DRuggeri/labinator_site/content/docs/buildlog/images/20250603_185943.jpg

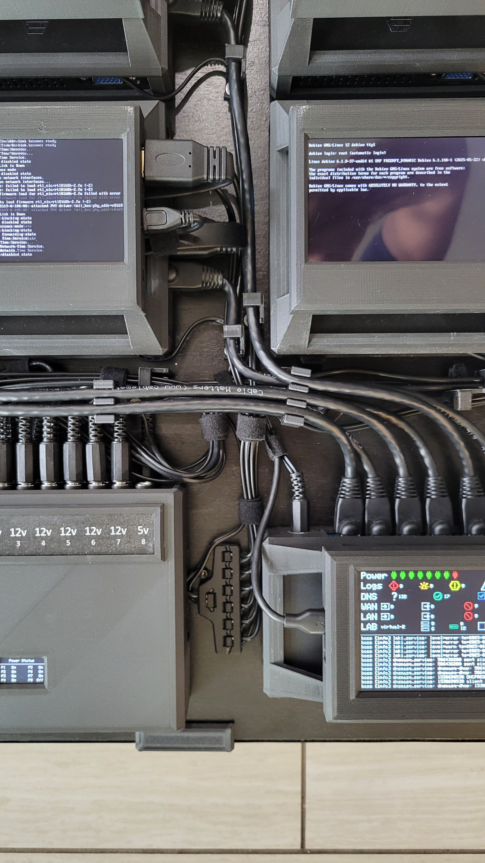
content/docs/buildlog/images/20250603_185943.jpg
