DRuggeri/labinator_site/content/docs/thanks.md

---
Title: Words of Thanks
---

A few content creators and "random Internet folks" have taken the time to share their learnings, code, and links on various blogs or sites. Some have been so handy they are worth a shoutout. I started collecting some of these links far too late in the process so only wish I had the foresight to create an index since the get-go!

#### People
* Thanks to [Werner Rothschopf](https://werner.rothschopf.net/index.htm) for sharing his [analysis of the ESP32 relay board](https://werner.rothschopf.net/microcontroller/202208_esp32_relay_x8_en.htm)
* Thanks to [Dawid Zyla](https://www.dzyla.com/about/about/) for sharing his [quick and easy Hugo shortcode for image galleries](https://www.dzyla.com/blog/post38/)
* Thanks to [Nelson Morais](https://www.linkedin.com/in/njmorais/) for his work [reverse engineering a marionette client for Gecko](https://github.com/njasm/marionette_client)
* Thanks to [Martino](https://martinomagnifico.github.io) for the handy reveal.js plugins he made like [simplemenu](https://github.com/martinomagnifico/reveal.js-simplemenu)
* Thanks to [Felix Stein](https://flxn.de/) for the awesome [QR Code STL file generator](https://printer.tools/qrcode2stl/) (and other cool stuff on [printer.tools](https://printer.tools/))
* Thanks to [Shuntaro Nishizawa](https://s2n.tech/) for the handy [SVG to favicon generator](https://favicon-generator.s2n.tech/)

#### Projects
* [Iconify](https://iconify.design/) - a project by [Vjacheslav Trushkin](https://iconify.design/about/) to collect Open Source icons
* [Hugo](https://gohugo.io/) - the best static content site generator which has rendered these pages you're viewing
* [Hextra](https://imfing.github.io/hextra/) - Hugo theme by [Xin](https://imfing.com/) to make a decent looking site
* [reveal.js](https://revealjs.com/) created by [Hakim El Hattab](https://twitter.com/hakimel) - for an awesome presentation framework to make the lab display
* [PlatformIO](https://platformio.org/) community - making ESP32 embedded development better every day
