DRuggeri/labinator_site/content/docs/subprojects/_index.md

---
title: Subprojects
weight: 3
---
Labinator is a pretty cool project overall, but it is composed of a several sidequests, too!

The pages here are some lighter-weight documentation about those projects, their motivations, and why they came into being.

## Core Components

- **[Labwatch](/docs/subprojects/labwatch/)** - Main lab controller and orchestrator
- **[Relayinator](/docs/subprojects/relayinator/)** - Power management and relay control
- **[Statusinator](/docs/subprojects/statusinator/)** - Status display and monitoring
- **[Boss](/docs/subprojects/boss/)** - Configuration for the boss under the screens
