DRuggeri/labinator_site/content/_index.md

---
toc: false
layout: hextra-home
---

{{< hextra/hero-container
  image="/images/landing.png"
  imageTitle="Labinator"
  imageWidth="999999"
>}}

<div class="hx-mt-6 hx-mb-6">
{{< hextra/hero-headline >}}
  Labinator
{{< /hextra/hero-headline >}}
</div>

<div class="hx-mt-6 hx-mb-6">
{{< hextra/hero-subtitle >}}
  Labinator is the outcome of several weeks of experimentation and playing in my homelab. At the time, my main objective was to experiment with lightweight ways to stand up, run, and operate a Kubernetes cluster. This is awesome both for home use and [dayjob](https://www.linkedin.com/in/danielruggeri). After all - rapid experimentation allows for quick try/fail/retry cycles until a winning combination is found!
{{< /hextra/hero-subtitle >}}
</div>

<div class="hx-mt-6 hx-mb-6">
{{< hextra/hero-button text="Check it out" link="docs/" >}}
</div>
{{< /hextra/hero-container >}}
