DRuggeri/labinator_site/content/docs/improve/images/loadstatus.png

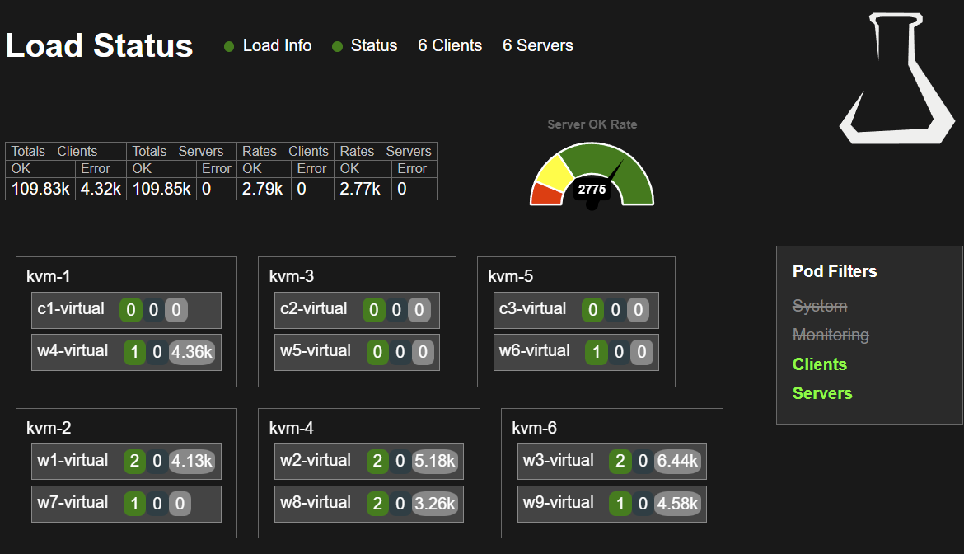
content/docs/improve/images/loadstatus.png
