DRuggeri/labinator_site/content/docs/improve/images/ogstatus.png

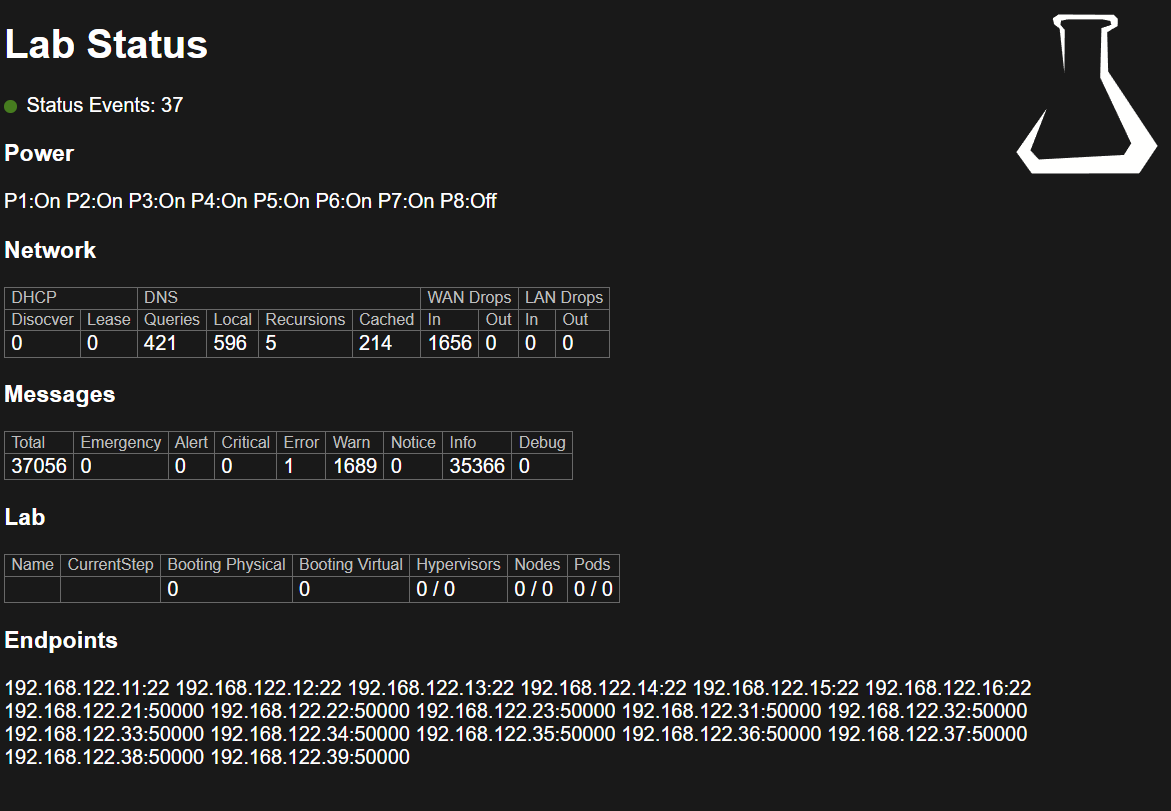
content/docs/improve/images/ogstatus.png
