DRuggeri/labinator_site/content/docs/layout/images/layout-export-boss.png

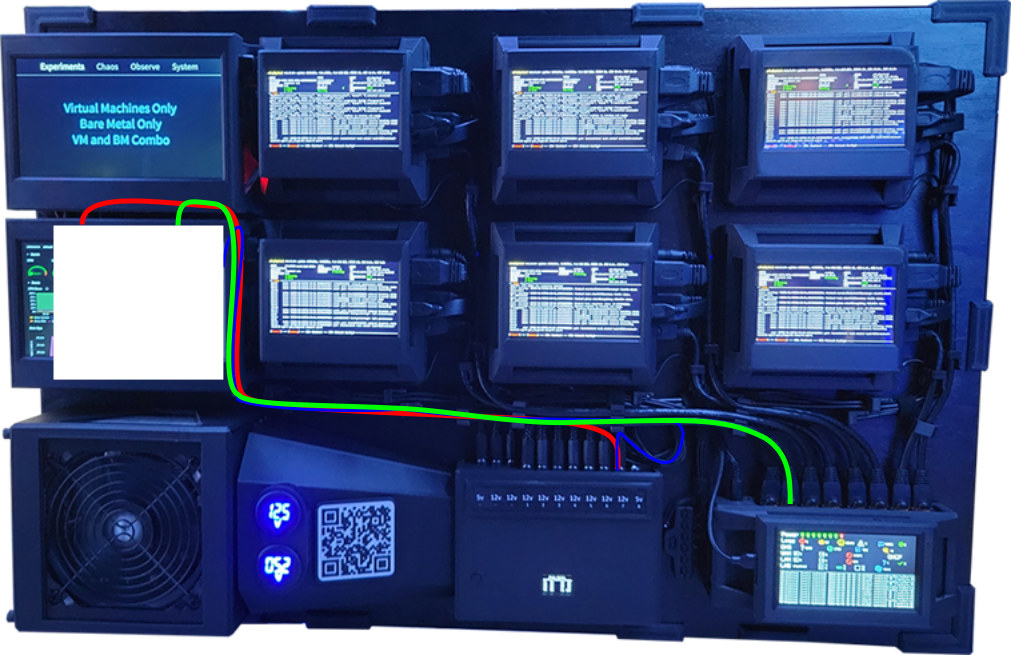
content/docs/layout/images/layout-export-boss.png
