DRuggeri/labinator_site/content/docs/layout/images/layout-export-node1.png

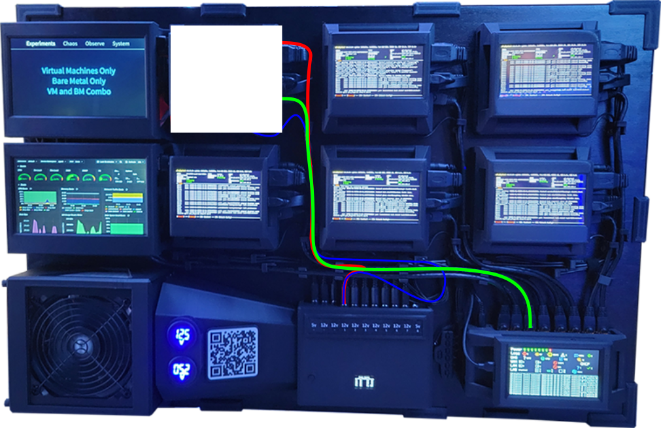
content/docs/layout/images/layout-export-node1.png
