DRuggeri/labinator_site/content/docs/layout/images/layout-export-node2.png

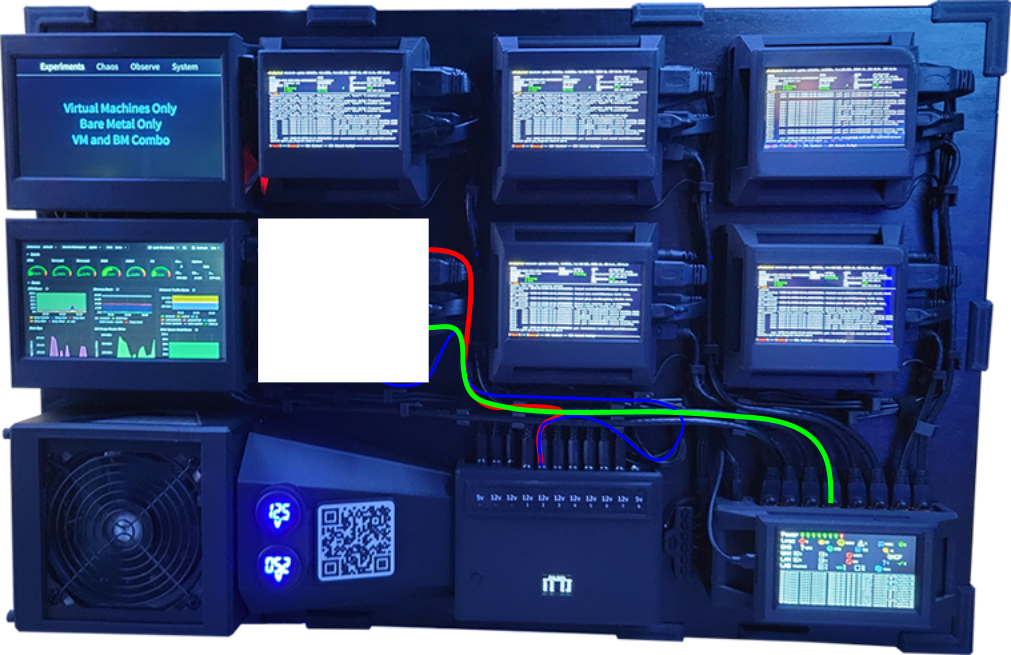
content/docs/layout/images/layout-export-node2.png
