DRuggeri/labinator_site/content/docs/layout/images/layout-export-node3.png

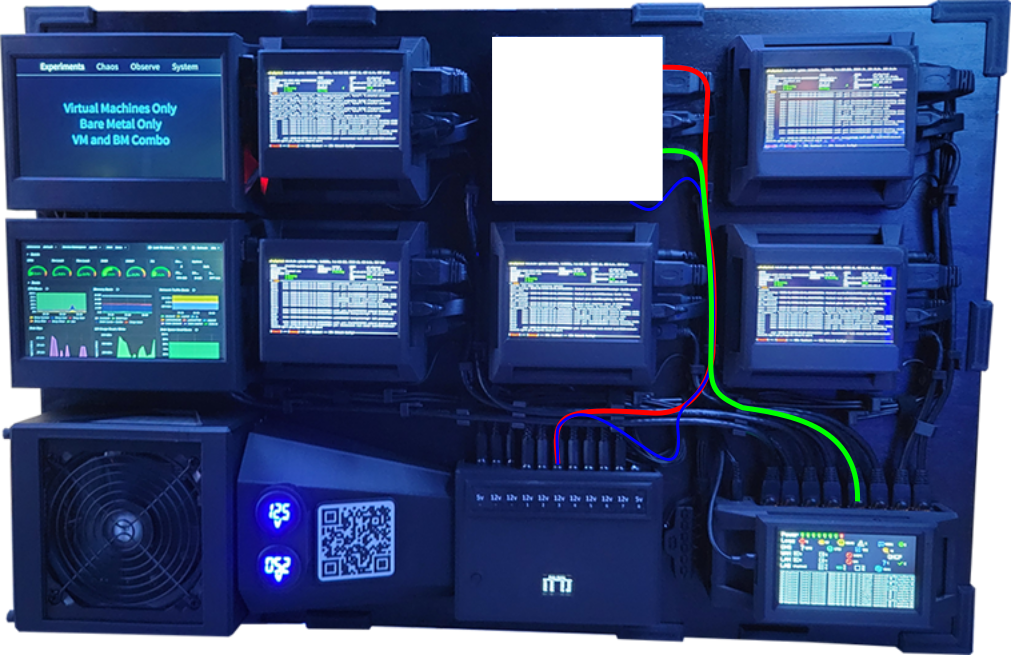
content/docs/layout/images/layout-export-node3.png
