DRuggeri/labinator_site/content/docs/layout/images/layout-export-node4.png

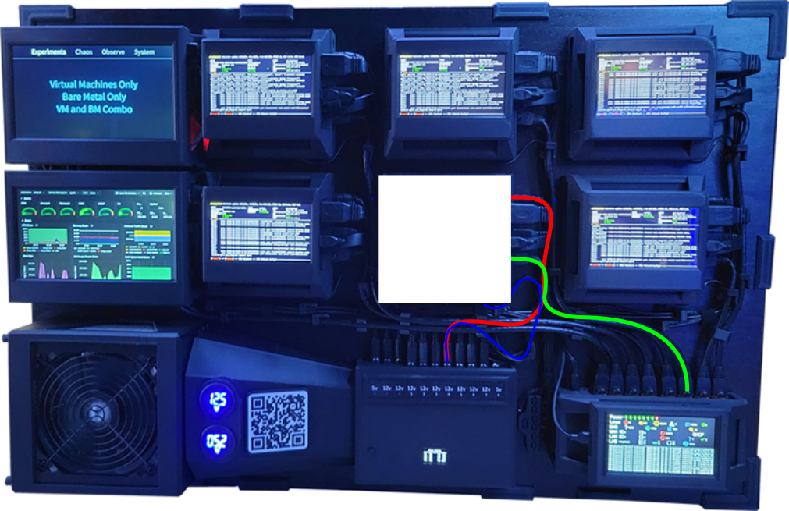
content/docs/layout/images/layout-export-node4.png
