DRuggeri/labinator_site/content/docs/layout/images/layout-export-node5.png

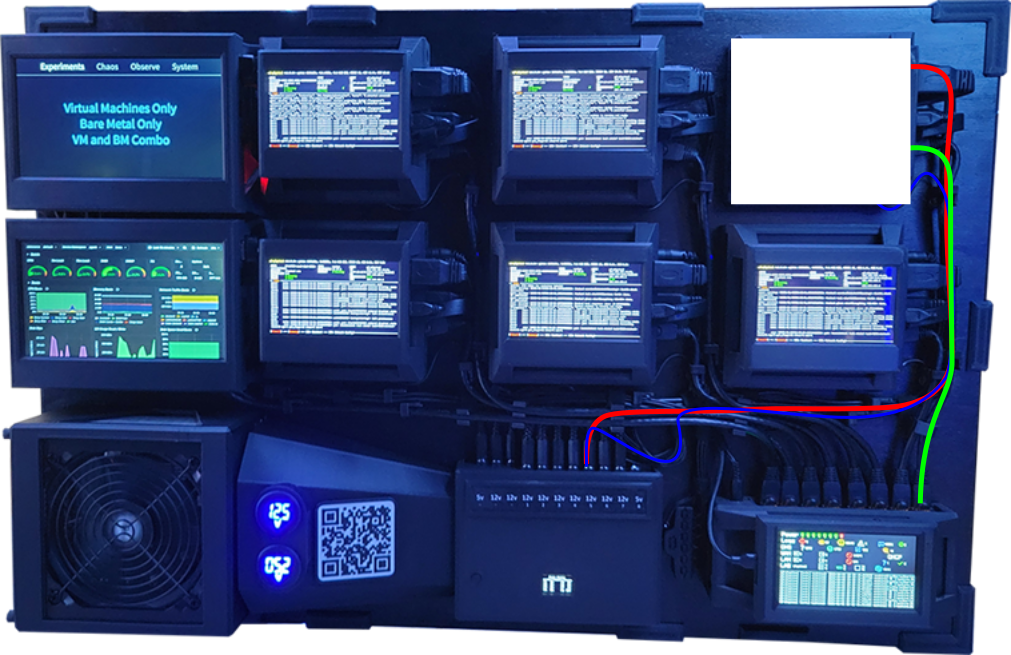
content/docs/layout/images/layout-export-node5.png
