DRuggeri/labinator_site/content/docs/layout/images/layout-export-node6.png

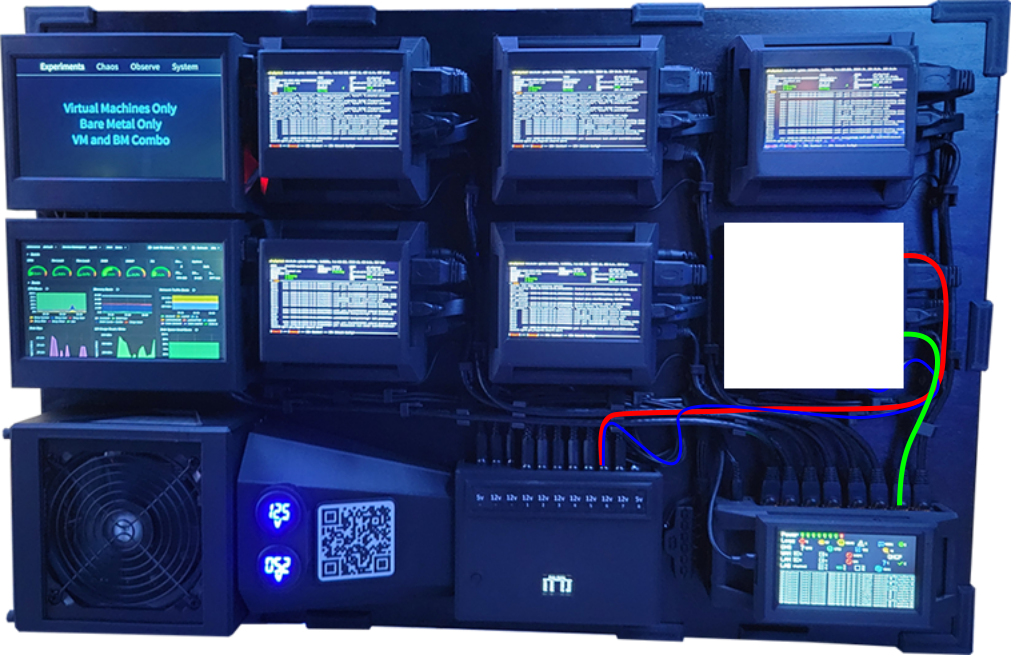
content/docs/layout/images/layout-export-node6.png
