DRuggeri/labinator_site/content/docs/layout/images/layout-export-relayinator.png

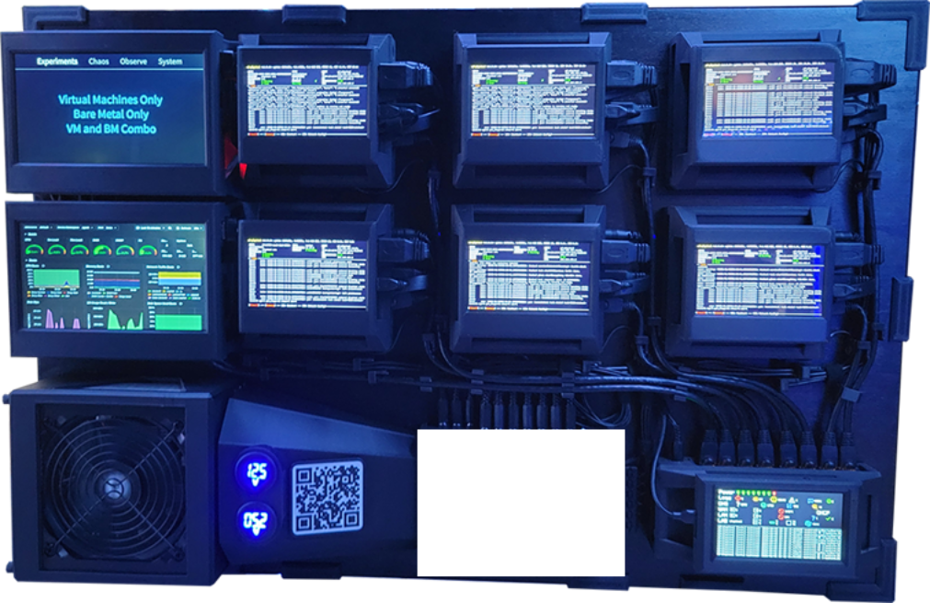
content/docs/layout/images/layout-export-relayinator.png
