DRuggeri/labinator_site/content/docs/layout/images/layout-export-statusinator.png

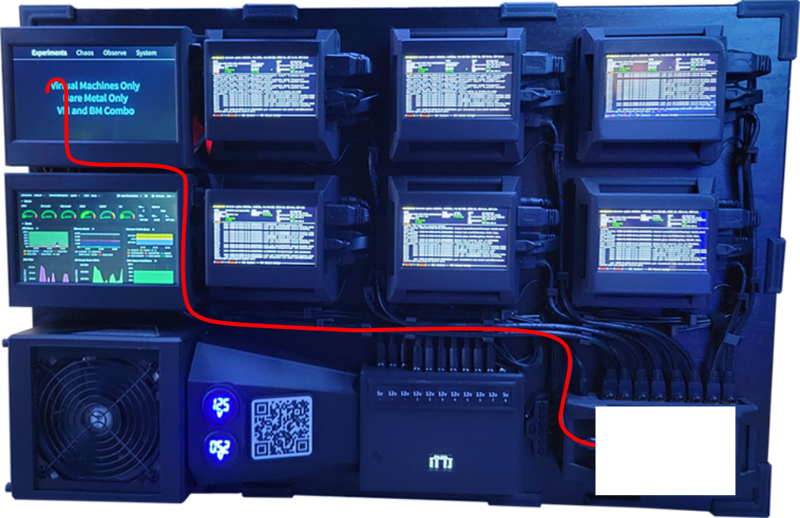
content/docs/layout/images/layout-export-statusinator.png
