DRuggeri/labinator_site/content/docs/layout/images/layout-export.png

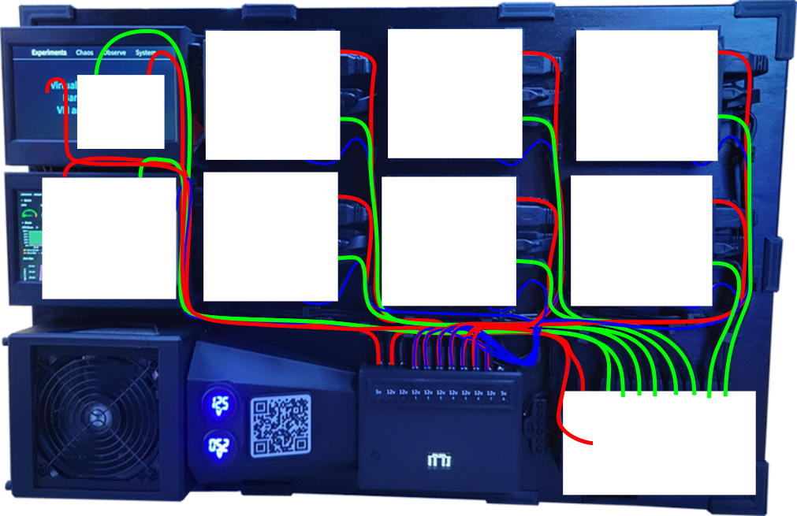
content/docs/layout/images/layout-export.png
