DRuggeri/labinator_site/content/docs/subprojects/relayinator/images/20250119_201037.jpg

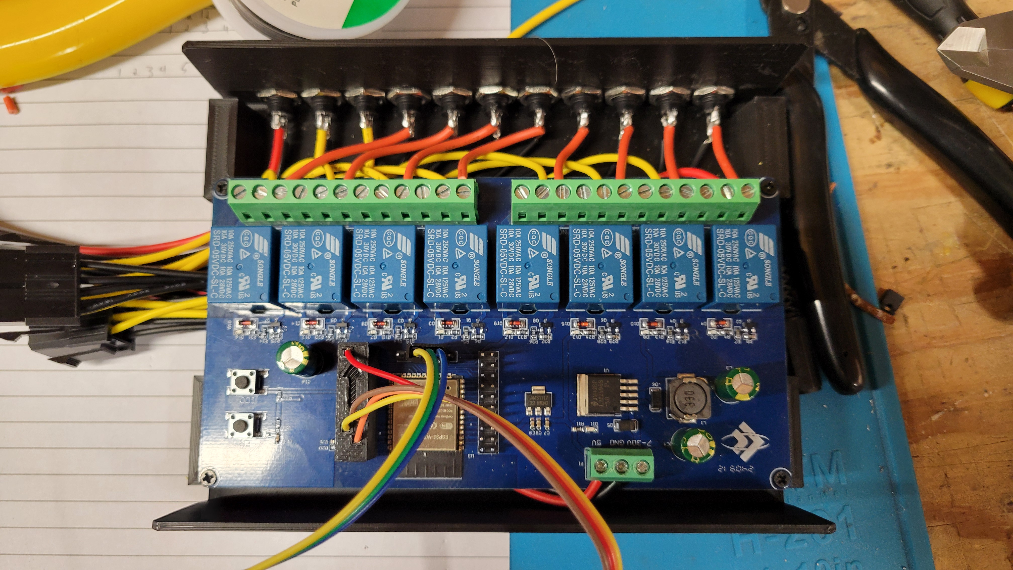
content/docs/subprojects/relayinator/images/20250119_201037.jpg
