DRuggeri/labinator_site/content/docs/subprojects/relayinator/images/20250323_155620.jpg

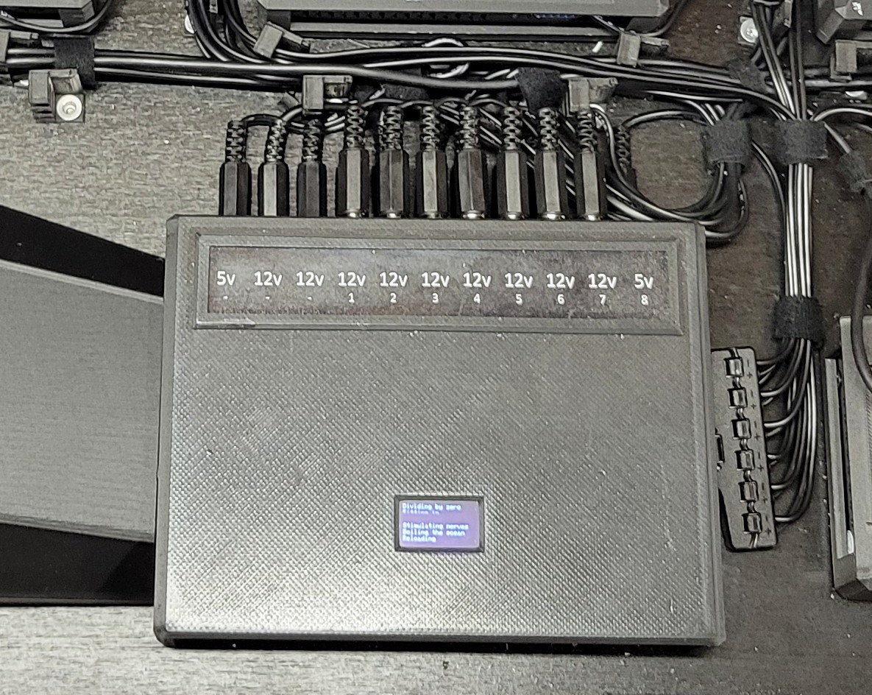
content/docs/subprojects/relayinator/images/20250323_155620.jpg
