DRuggeri/labinator_site/content/docs/subprojects/relayinator/images/20250323_155624.jpg

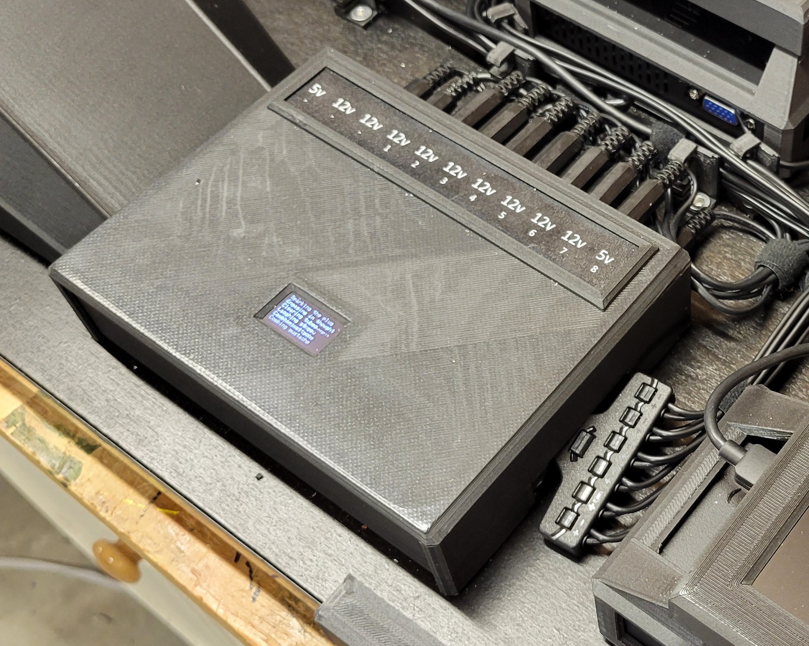
content/docs/subprojects/relayinator/images/20250323_155624.jpg
