DRuggeri/labinator_site/content/docs/subprojects/relayinator/images/20250603_185526.jpg

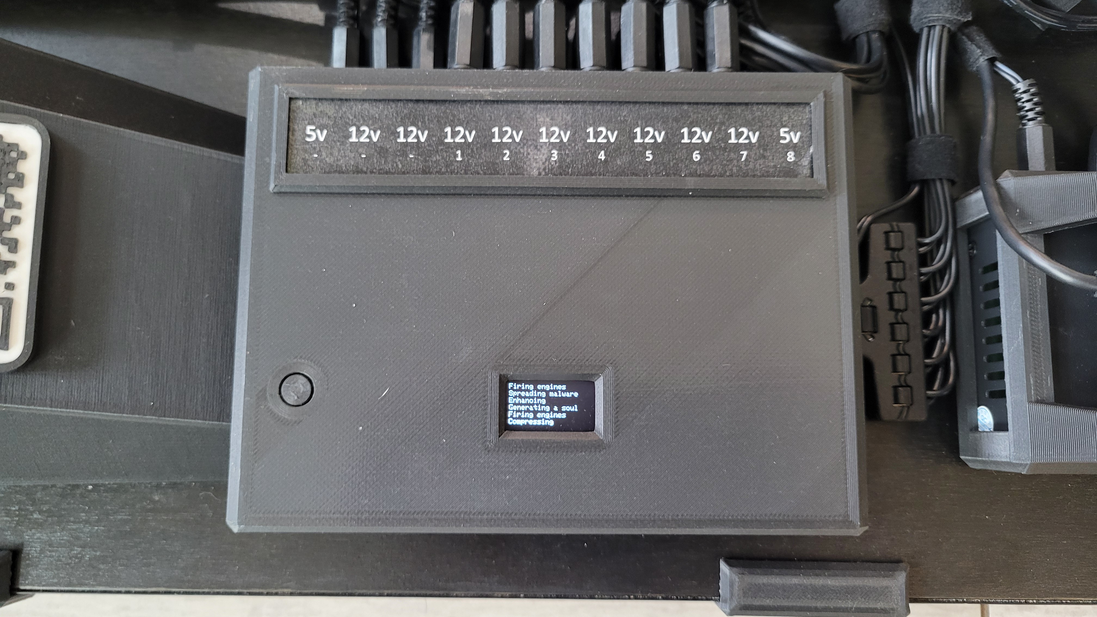
content/docs/subprojects/relayinator/images/20250603_185526.jpg
