DRuggeri/labinator_site/content/docs/subprojects/statusinator/images/20250603_185522.jpg

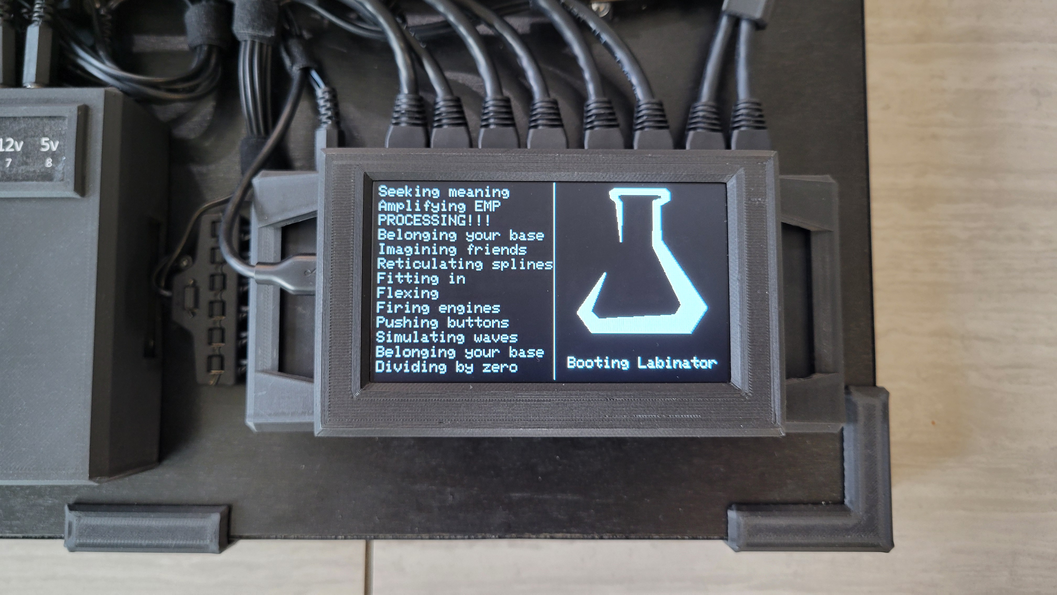
content/docs/subprojects/statusinator/images/20250603_185522.jpg
