DRuggeri/labinator_site/content/docs/subprojects/statusinator/images/20250603_190112.jpg

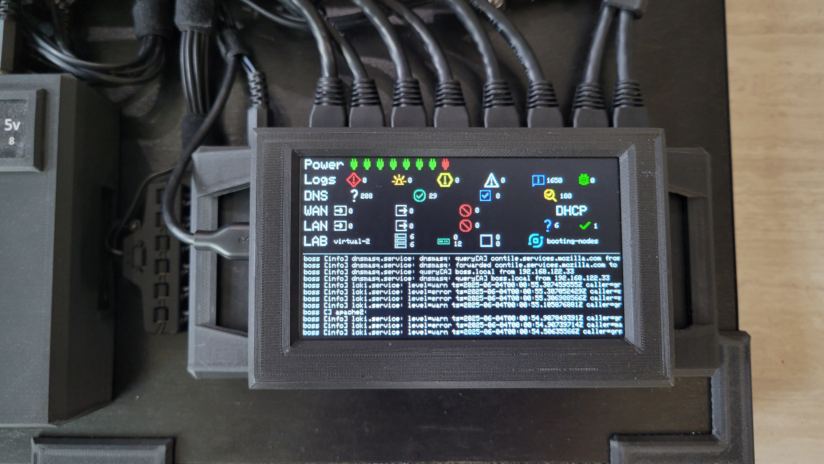
content/docs/subprojects/statusinator/images/20250603_190112.jpg
