DRuggeri/labinator_site/static/android-chrome-192x192.png

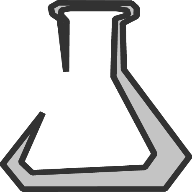
static/android-chrome-192x192.png
