DRuggeri/labinator_site/static/images/landing.jpg

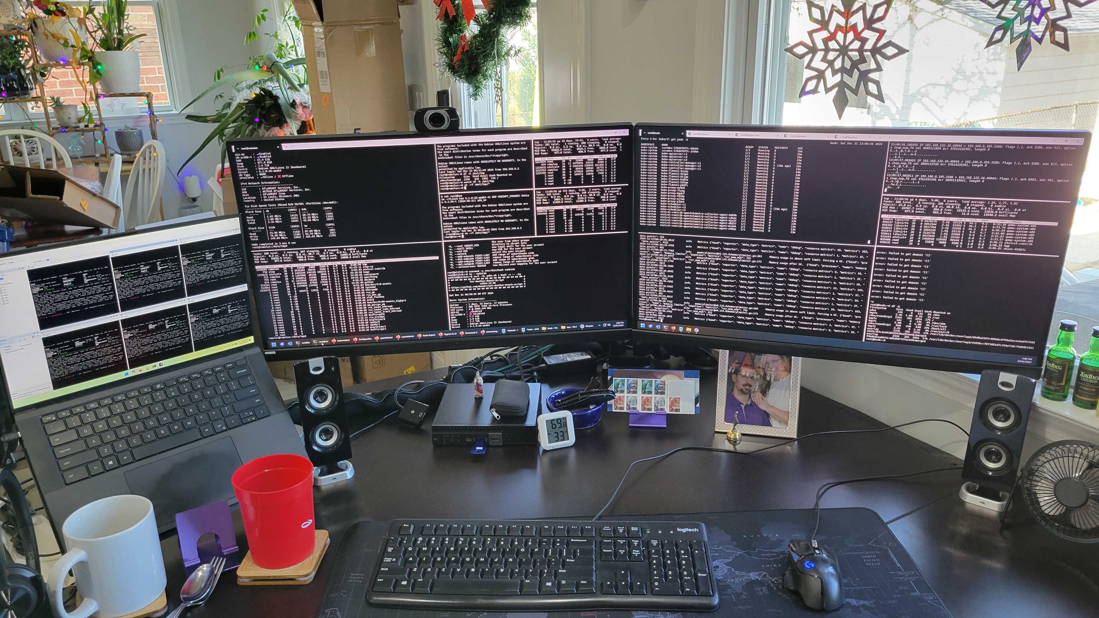
static/images/landing.jpg
