DRuggeri/labinator_site/static/images/models.png

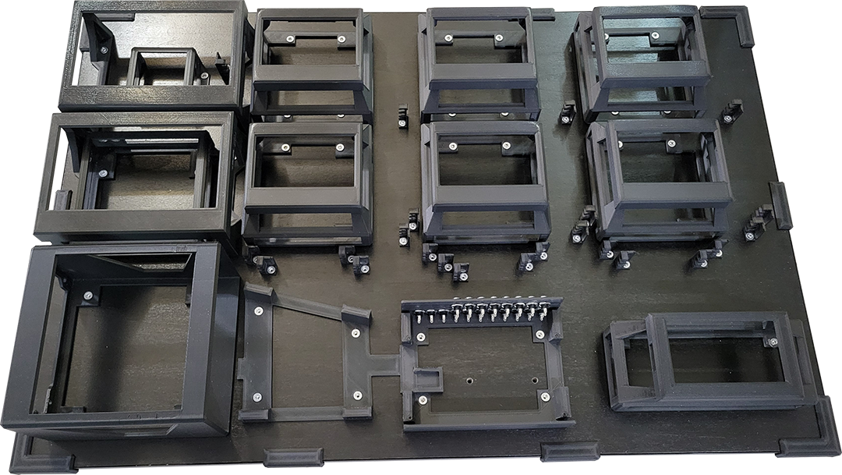
static/images/models.png
