DRuggeri/labinator_site/content/docs/bom.md

---
Title: Bill of Materials
layout: bom
Weight: 6
params:
  parts:
  - item: FriendlyElec NanoPi R3S
    description: Ingress router and firewall running OpenWRT
    link: https://www.aliexpress.us/item/3256807441571917.html
    price: 47.67
    quantity: 1
    purpose: core
  - item: Hasivo S800W-8G-SE 8 port managed switch
    description: Network switch with VLAN support
    link: https://www.aliexpress.us/item/3256804662423078.html
    price: 38.00
    quantity: 1
    purpose: core
  - item: MLLSE M2 Pro Mini PC
    description: Celeron J3710 CPU, 8G RAM, 256G SATA SSD. 6 nodes and 1 boss
    link: https://www.aliexpress.us/item/3256807948148460.html
    price: 79.00
    quantity: 7
    purpose: core
  - item: Apevia ATX-SP700 Spirit ATX power supply
    description: 115/230v power supply with 120mm fan
    link: https://www.amazon.com/dp/B08BZYG24D
    price: 36.99
    quantity: 1
    purpose: core

  - item: ESP32 8 relay DC module
    description: The relayinator used to power off or power on machines by triggering button presses
    link: https://www.aliexpress.com/item/3256806837227699.html
    price: 15.65
    quantity: 1
    purpose: extras
  - item: FT232RL FTDI USB to Serial Adapter
    description: Serial to USB adapater for boss to talk to relayinator
    link: https://www.aliexpress.us/item/3256807353577995.html
    price: 1.47
    quantity: 1
    purpose: extras
  - item: 5 pcs OLED I2C mini display
    description: Display module for relayinator to show statuses
    link: https://www.amazon.com/dp/B09T6SJBV5
    price: 14.99
    quantity: 1
    purpose: extras
  - item: 3x Mini USB cable
    description: Who uses Mini USB these days
    link: https://www.amazon.com/dp/B0D4QZRS59
    price: 6.99
    quantity: 1
    purpose: extras
  - item: 8 pin ATX EPS extension
    description: Used to adapt ATX power supply wire from harness to relayinator. Not needed if splicing directly from power supply.
    link: https://www.aliexpress.com/item/3256806334020742.html
    price: 1.26
    quantity: 1
    purpose: extras
  - item: PCI Express 6 pin extension
    description: Used to adapt ATX power supply wire from harness to relayinator. Not needed if splicing directly from power supply.
    link: https://www.aliexpress.com/item/3256804347520048.html
    price: 1.61
    quantity: 1
    purpose: extras
  - item: 2.8mm spade crimp terminals
    description: Female terminals to connect ATX extension wires to panel barrel jacks
    link: https://www.amazon.com/dp/B09L7KGSVS
    price: 6.99
    quantity: 1
    purpose: extras
  - item: 24 pcs 5.5mm  x 2.1mm barrel connectors
    description: Female barrel jack panel mount terminals for power and relays
    link: https://www.amazon.com/dp/B07CTCLKPP
    price: 6.99
    quantity: 1
    purpose: extras
  - item: 4 - 100v LED voltmeter
    description: Measures volts on the 5v and 12v rails of the power supply
    link: https://www.aliexpress.com/item/3256806796428024.html
    price: 1.19
    quantity: 2
    purpose: extras

  - item: Black Cat 6 eithernet cable
    description: Cable Matters 25ft snagless cable
    link: https://www.amazon.com/dp/B007NZGPAY
    price: 9.99
    quantity: 1
    purpose: wiring
  - item: 10pcs 5.5mm x 2.1mm male barrel plug
    description: Connects devices to power supply or relayinator
    link: https://www.aliexpress.us/item/2251832799665839.html
    price: 1.76
    quantity: 3
    purpose: wiring
  - item: 5.5mm x 2.1mm barrel to USB C adapter
    description: Adapts lab power wiring to USB C for the NanoPi R3S
    link: https://www.aliexpress.us/item/3256804472451471.html
    price: 2.1
    quantity: 1
    purpose: wiring
  - item: 18awg 2 pin wire
    description: Low voltage power wires from relayinator to all devices
    link: https://www.aliexpress.com/item/3256802385447751.html
    price: 13.30
    quantity: 1
    purpose: wiring

  - item: Overture Matte black 1.75mm PLA filament
    description: 1kg spool of filament for the 3D printed mounts
    link: https://www.amazon.com/dp/B089S2QDHD
    price: 18.99
    quantity: 3
    purpose: mounting
  - item: 50pcs M3 x 14mm stainless thumb screws
    description: Used to secure the lab components to the portable board
    link: https://www.aliexpress.com/item/2251832782168715.html
    price: 1.83
    quantity: 1
    purpose: mounting
  - item: 100 pcs M3 flat washers
    description: Black washers for the thumb screws
    link: https://www.amazon.com/dp/B0DDTNVRZW
    price: 5.49
    quantity: 1
    purpose: mounting
  - item: M3 x 8mm stainless pan head screws
    description: Used to secure screens to the mounts
    link: https://www.amazon.com/dp/B01BBOZGKC
    price: 6.66
    quantity: 1
    purpose: mounting
  - item: 1/2 self-stick edge trim
    description: Finishes the cut edges of the mounting board
    link: https://www.amazon.com/dp/B0CG23TG7G
    price: 9.99
    quantity: 1
    purpose: mounting

  - item: ESP32-S3 4.3-inch LCD module
    description: Used to display stats of the lab
    link: https://www.aliexpress.com/item/3256806622242278.html
    price: 15.82
    quantity: 1
    purpose: display
  - item: 7-inch LCD IPS touchscreen
    description: Large touchscreens for steering the lab interactively
    link: https://www.aliexpress.us/item/3256807619360520.html
    price: 30.41
    quantity: 2
    purpose: display
  - item: 4.3-inch LCD HDMI screen, no touch
    description: Displays for the lab boxes
    link: https://www.aliexpress.us/item/3256806922131724.html
    price: 22.30
    quantity: 6
    purpose: display
  - item: 5.5mm x 2.1 barrel to micro USB adapter
    description: Adapts lab power wiring to micro USB used by the screens
    link: https://www.aliexpress.us/item/3256806922131724.html
    price: 1.98
    quantity: 1
    purpose: display
  - item: USB 3.0 to HDMI adapter
    description: Boss only has one HDMI output so this adds a second
    link: https://www.aliexpress.com/item/3256807369692765.html
    price: 5.30
    quantity: 1
    purpose: display
  - item: 180 degree HDMI adapter
    description: Flips HDMI outputs for the large screens so the cables do not interfere with the lab
    link: https://www.aliexpress.com/item/3256805564650477.html
    price: 1.87
    quantity: 2
    purpose: display
  - item: 180 degree Micro USB adapter
    description: Flips USB inputs for the large screens so the cables do not interfere with the lab
    link: https://www.aliexpress.com/item/3256805564650477.html
    price: 1.23
    quantity: 4
    purpose: display
  - item: 2 in 12 out power splitter
    description: Distributes power from 5v rail to the 6 worker screens
    link: https://www.aliexpress.com/item/3256804734413714.html
    price: 1.97
    quantity: 1
    purpose: display

---
One of the defining tenants for Labinator is that it had to [use cheap, commodity hardware](../about/#why-cheap-hardware). The bulk of the cost, therefore, comes from consumer grade hardware you can find from places like AliExpress or Amazon to keep the prices as low as possible.

The bulk of the lab can be built for well under $1,000 USD. However, to be a little flashy and clever, some extras were added such as the [relayinator](../subprojects/relayinator) (which "presses" the power buttons of the lab gear to turn the machines on and off). The lab is also intended to be mobile and demonstrative of the technologies in use, so each machine has one or more monitors attached to it to allow the observer to see what is going on with each machine at any given time. To stay mobile, a ton of [3D printed models](/docs/models/) are used to arrange the devices on a mobile board and to mount screens and wires. You can use the filters below to hide such extras.
