DRuggeri/labinator_site/static/models/Mounting Lug.stl

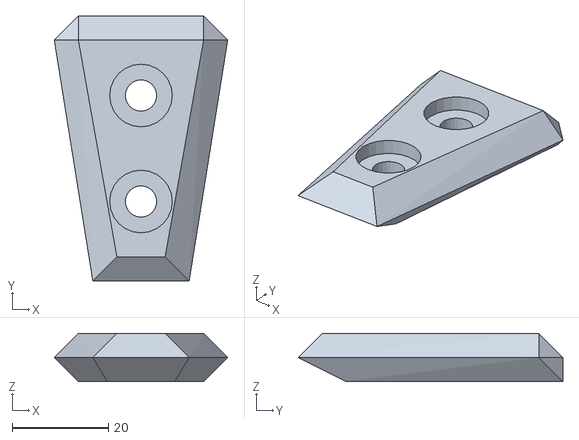
[picture p24: CAD file, 2025-09-26]
static/models/Mounting Lug.stl
36.0 x 55.0 x 10.0
