DRuggeri/labinator_site/static/models/Carry Handle.stl

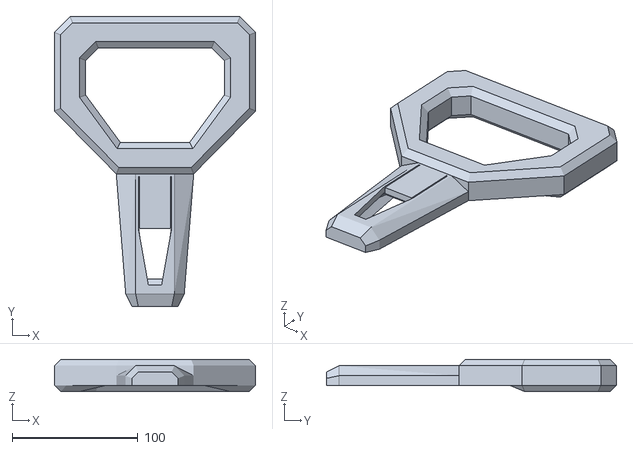
[picture p25: CAD file, 2025-09-26]
static/models/Carry Handle.stl
160.0 x 230.3 x 25.5
