DRuggeri/labinator_site/static/models/qrcode.stl

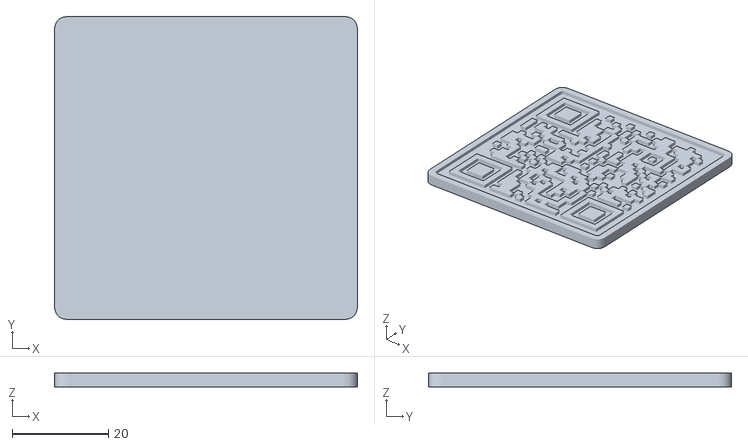
[picture p26: CAD file, 2025-09-26]
static/models/qrcode.stl
63.0 x 63.0 x 3.00
