DRuggeri/labinator_site/static/models/Power Wire Cover - top.stl

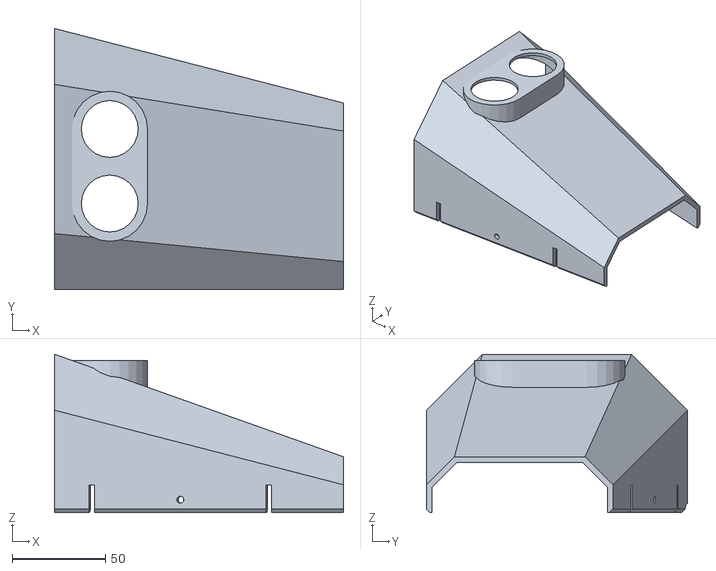
[picture p27: CAD file, 2025-09-14]
static/models/Power Wire Cover - top.stl
155.0 x 140.0 x 85.0
