DRuggeri/labinator_site/static/models/Power Wire Cover - bottom.stl

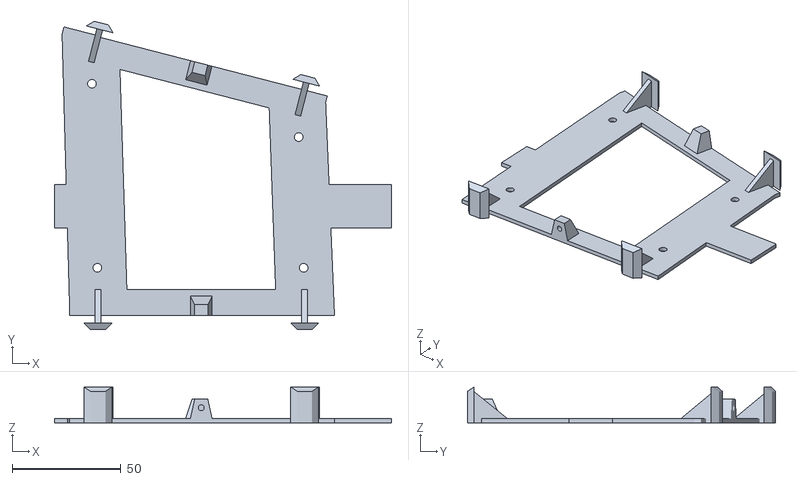
[picture p28: CAD file, 2025-09-14]
static/models/Power Wire Cover - bottom.stl
155.0 x 141.9 x 16.5
