DRuggeri/labinator_site/static/models/Platform Stand.stl

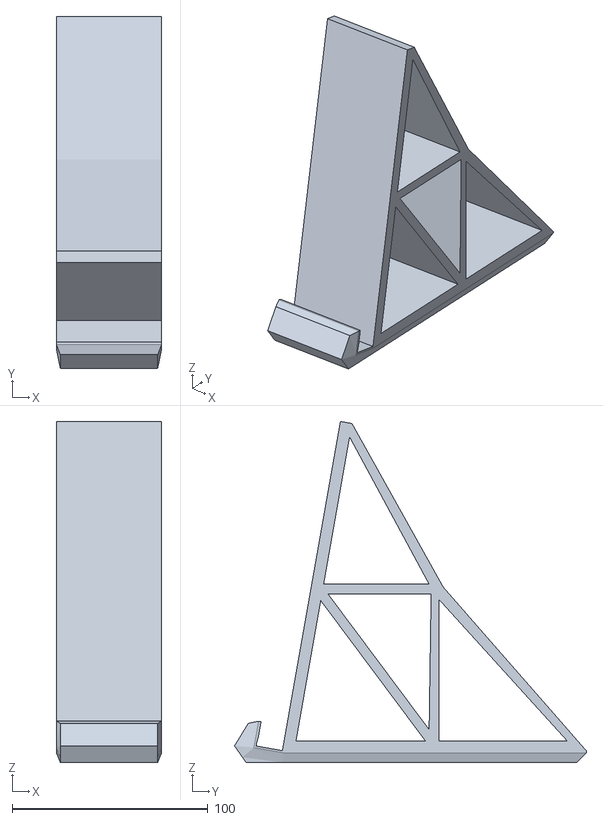
[picture p29: CAD file, 2025-06-04]
static/models/Platform Stand.stl
53.8 x 180.0 x 174.4
