DRuggeri/labinator_site/static/models/QRCode Holder.stl

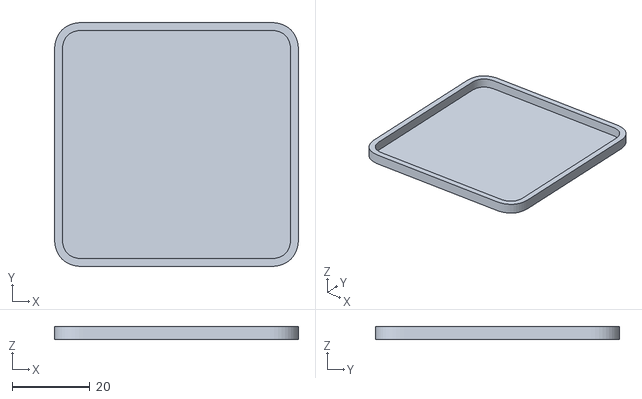
[picture p30: CAD file, 2025-04-13]
static/models/QRCode Holder.stl
62.6 x 62.6 x 3.25
