DRuggeri/labinator_site/static/models/LCD - Touch Mount - Minimal.stl

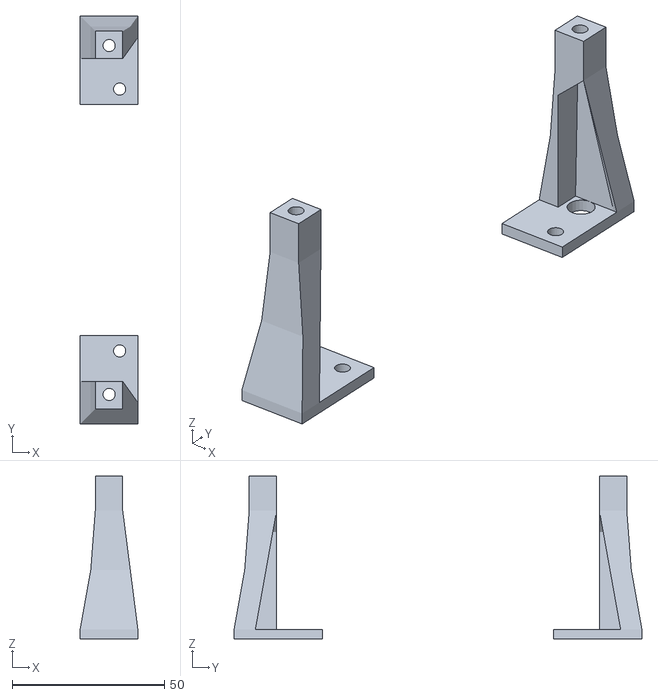
[picture p31: CAD file, 2025-03-30]
static/models/LCD - Touch Mount - Minimal.stl
19.0 x 134.0 x 53.4
