DRuggeri/labinator_site/static/models/USB Holster.stl

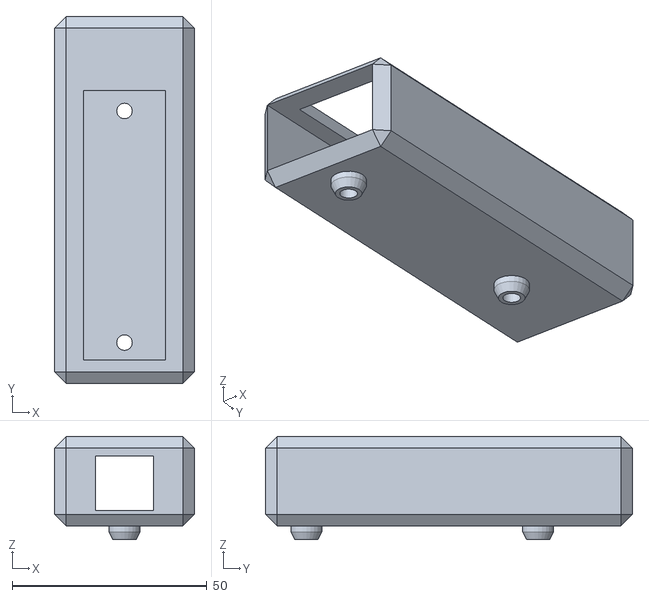
[picture p32: CAD file, 2025-03-27]
static/models/USB Holster.stl
36.0 x 94.3 x 26.5
