DRuggeri/labinator_site/static/models/Relayinator Top.stl

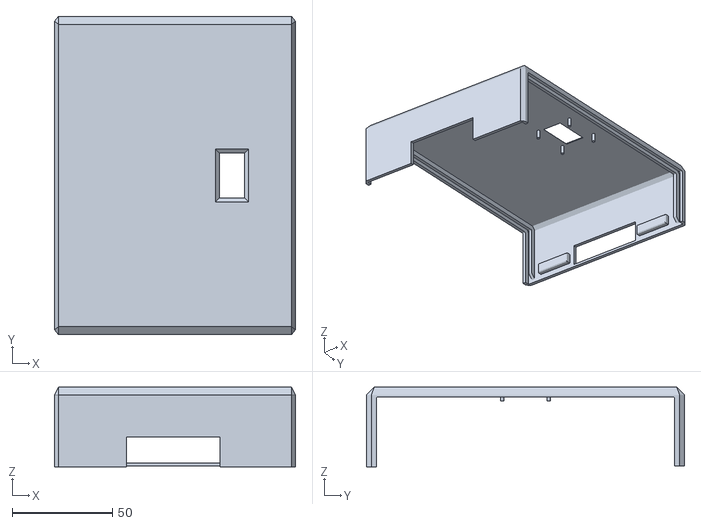
[picture p33: CAD file, 2025-03-16]
static/models/Relayinator Top.stl
120.5 x 159.2 x 39.9
