DRuggeri/labinator_site/static/models/Relayinator Bottom.stl

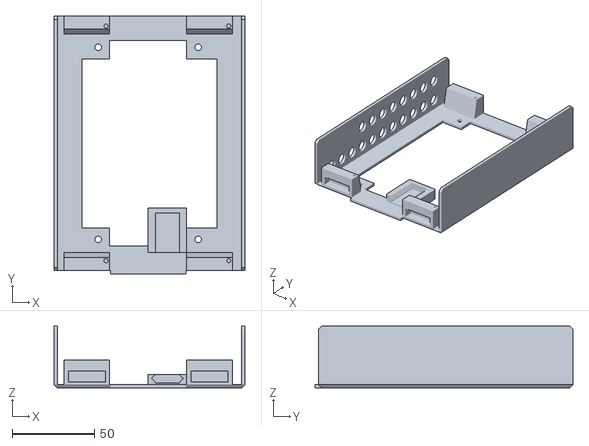
[picture p34: CAD file, 2025-03-16]
static/models/Relayinator Bottom.stl
115.9 x 156.6 x 37.6
