DRuggeri/labinator_site/static/models/R3S Holster.stl

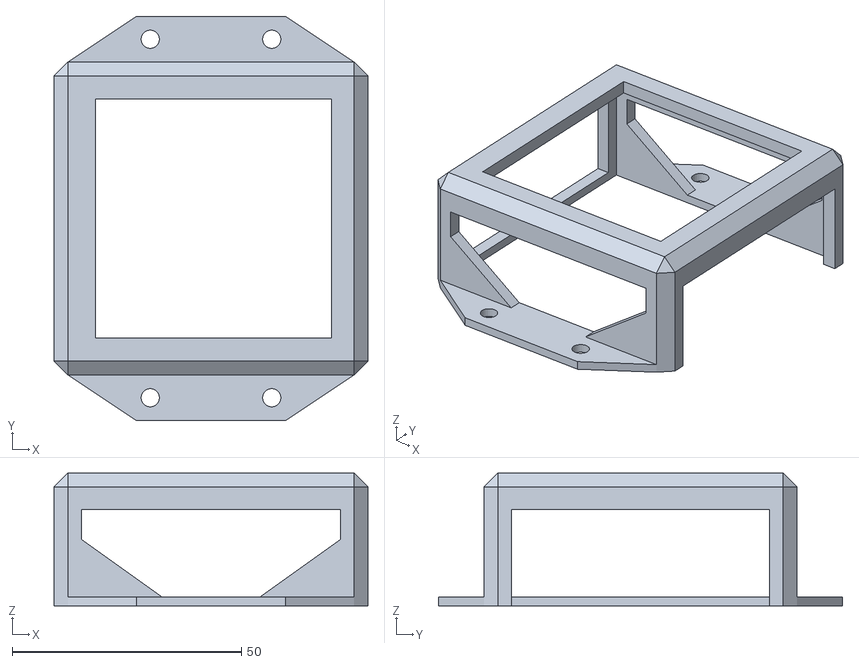
[picture p35: CAD file, 2025-03-07]
static/models/R3S Holster.stl
68.5 x 88.2 x 29.0
