DRuggeri/labinator_site/static/models/LCD - Touch Screen.stl

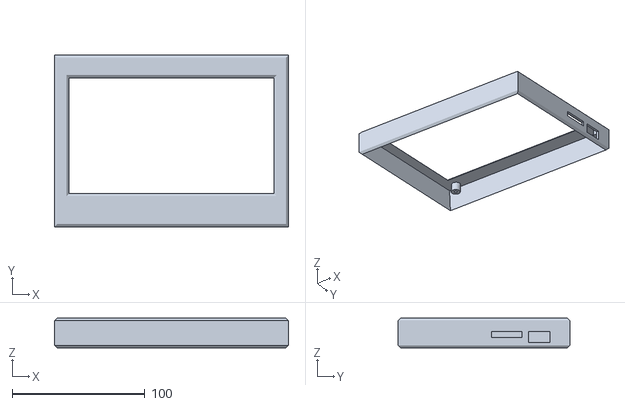
[picture p36: CAD file, 2025-03-07]
static/models/LCD - Touch Screen.stl
176.0 x 129.0 x 22.5
