DRuggeri/labinator_site/static/models/LCD - Touch Mount.stl

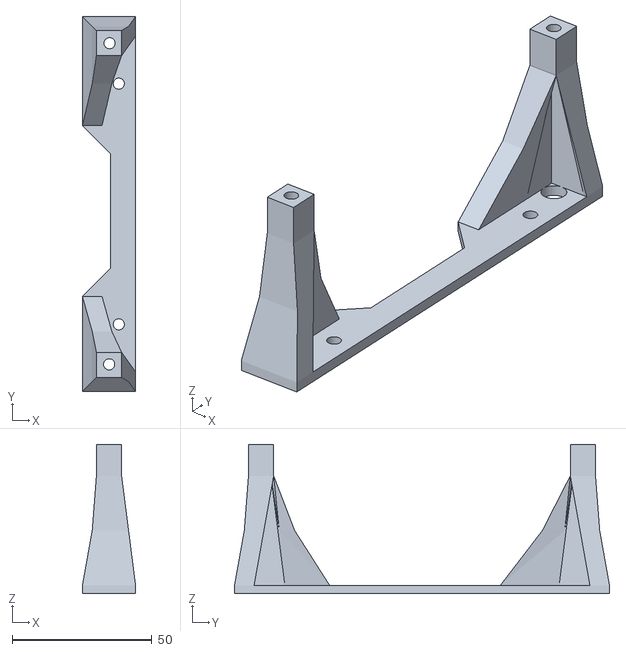
[picture p37: CAD file, 2025-03-07]
static/models/LCD - Touch Mount.stl
19.0 x 134.0 x 53.4
