DRuggeri/labinator_site/static/models/Cable Comb.stl

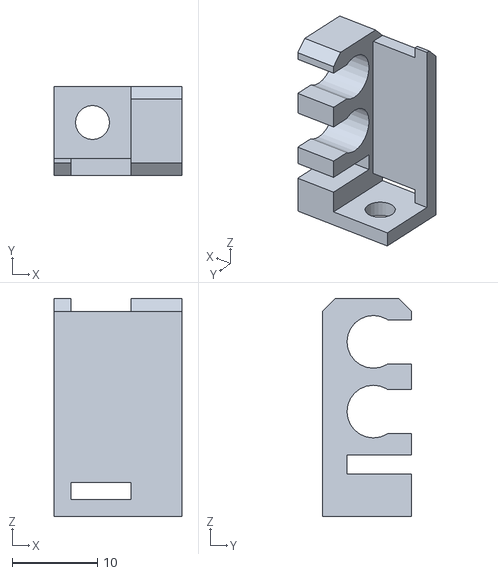
[picture p38: CAD file, 2025-03-07]
static/models/Cable Comb.stl
15.0 x 10.5 x 25.6
