DRuggeri/labinator_site/static/models/Platform corner leg.stl

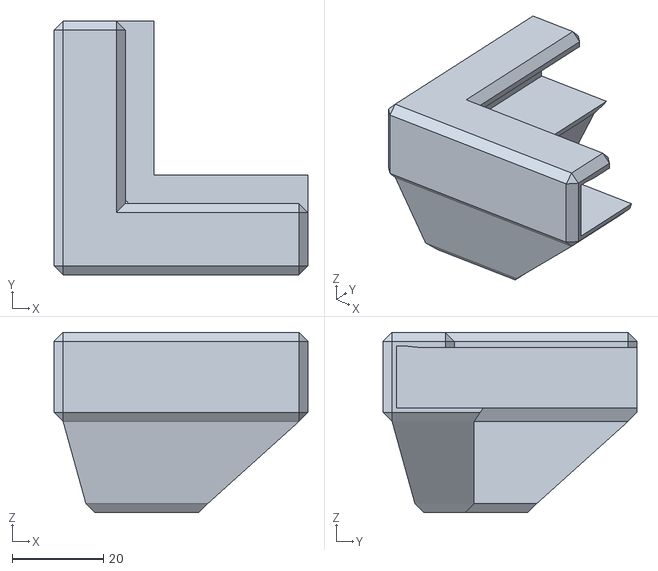
[picture p39: CAD file, 2025-03-07]
static/models/Platform corner leg.stl
55.8 x 55.8 x 39.6
