DRuggeri/labinator_site/static/models/Platform edge leg.stl

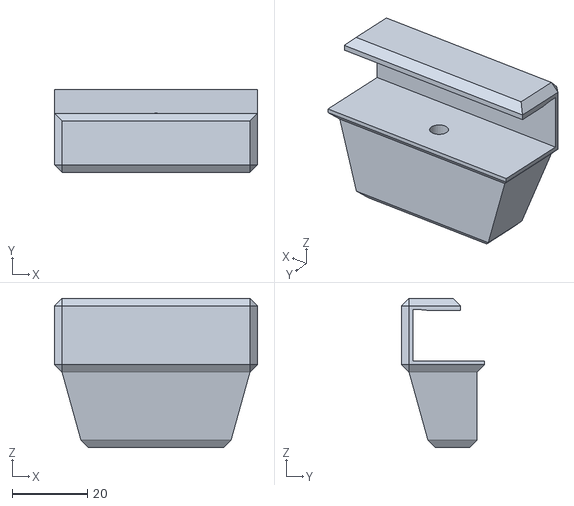
[picture p40: CAD file, 2025-03-07]
static/models/Platform edge leg.stl
53.8 x 22.0 x 39.6
