DRuggeri/labinator_site/static/models/ATX Mount.stl

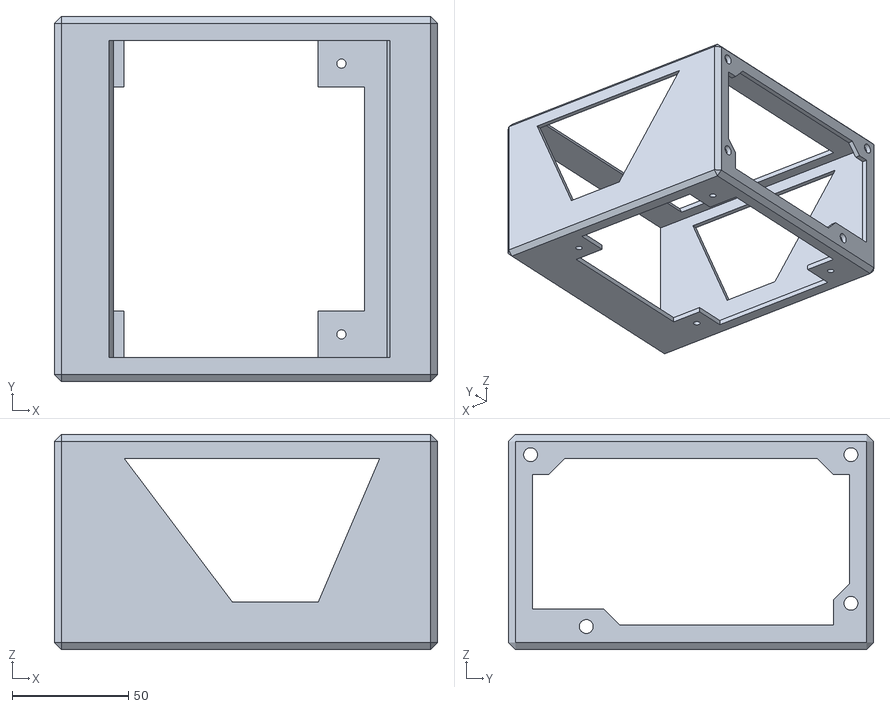
[picture p41: CAD file, 2025-03-07]
static/models/ATX Mount.stl
165.0 x 157.2 x 92.7
