DRuggeri/labinator_site/static/models/Holster with Screen.stl

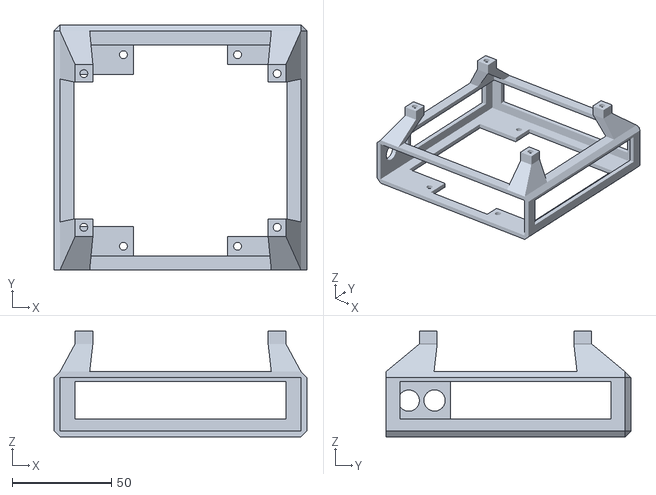
[picture p42: CAD file, 2025-02-15]
static/models/Holster with Screen.stl
127.6 x 123.6 x 53.4
