DRuggeri/labinator_site/static/models/ESPLCD Button.stl

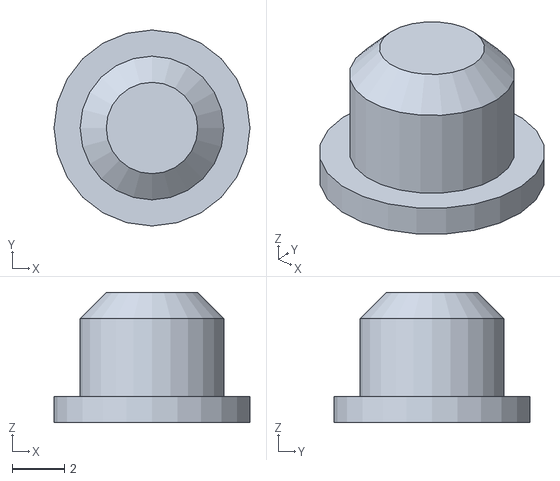
[picture p43: CAD file, 2025-02-15]
static/models/ESPLCD Button.stl
7.50 x 7.50 x 4.98
