DRuggeri/labinator_site/static/models/LCD - HDMI Screen.stl

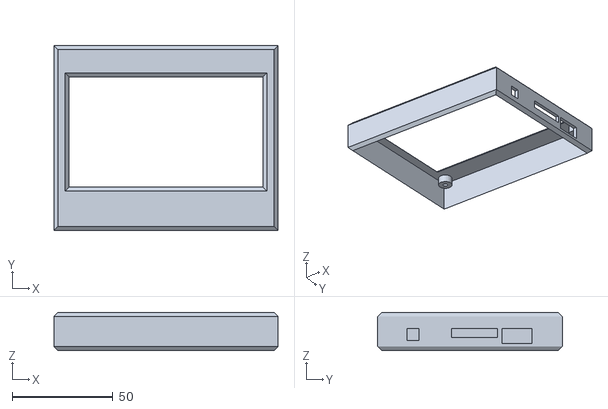
[picture p44: CAD file, 2025-02-15]
static/models/LCD - HDMI Screen.stl
111.0 x 91.5 x 19.0
