DRuggeri/labinator_site/static/models/Holster.stl

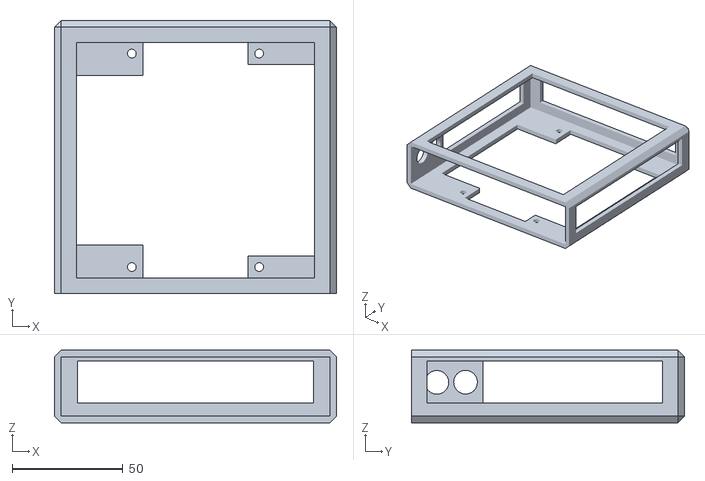
[picture p45: CAD file, 2025-02-15]
static/models/Holster.stl
127.6 x 123.6 x 32.9
