DRuggeri/labinator_site/static/models/Switch Holster.stl

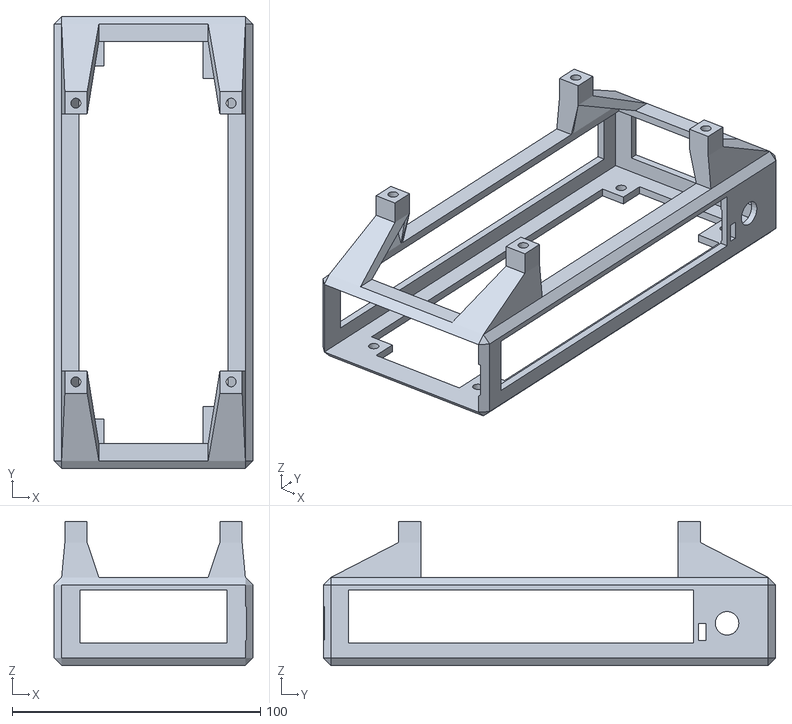
[picture p46: CAD file, 2025-02-15]
static/models/Switch Holster.stl
80.0 x 182.0 x 58.0
