DRuggeri/labinator_site/static/models/ESPLCD Screen.stl

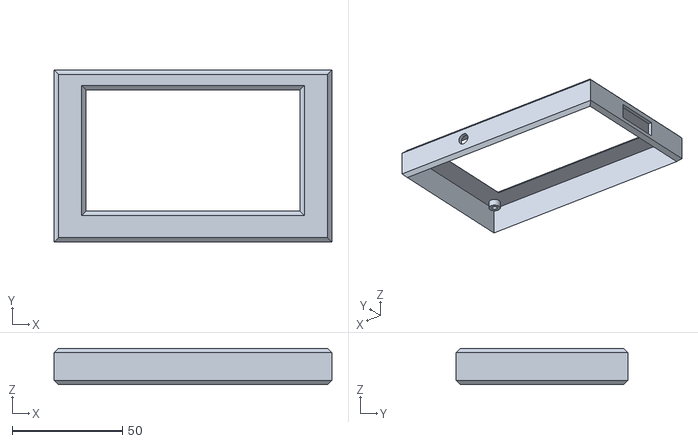
[picture p47: CAD file, 2025-02-15]
static/models/ESPLCD Screen.stl
126.0 x 78.0 x 16.5
