DRuggeri/labinator_site/(list of files, cad)

Other CAD files:
static/models/ATX Mount.skp
static/models/Cable Comb.skp
static/models/Carry Handle.skp
static/models/ESPLCD Button.skp
static/models/ESPLCD Screen.skp
static/models/Holster with Screen.skp
static/models/Holster.skp
static/models/LCD - HDMI Screen.skp
static/models/LCD - Touch Mount - Minimal.skp
static/models/LCD - Touch Mount.skp
static/models/LCD - Touch Screen.skp
static/models/Mounting Lug.skp
static/models/Platform Stand.skp
static/models/Platform corner leg.skp
static/models/Platform edge leg.skp
static/models/Power Wire Cover - bottom.skp
static/models/Power Wire Cover - top.skp
static/models/QRCode Holder.skp
static/models/R3S Holster.skp
static/models/Relayinator Bottom.skp
static/models/Relayinator Top.skp
static/models/Switch Holster.skp
static/models/USB Holster.skp
