DRuggeri/labinator_site/content/docs/buildlog/_index.md

---
title: Build Images
Weight: 5
---
Build log in pictures and prose. Click each picture to see the caption about what's going on. The far right and left of each image in the popup will move to the next or previous image, respectively.

{{<gallery_column folder="images/" randomize=false uniqueID="buildlog" scale=100% columns="3" gap=10 showAlt=true >}}
