DRuggeri/labinator_site/content/docs/buildlog/images/20250119_130754.jpg

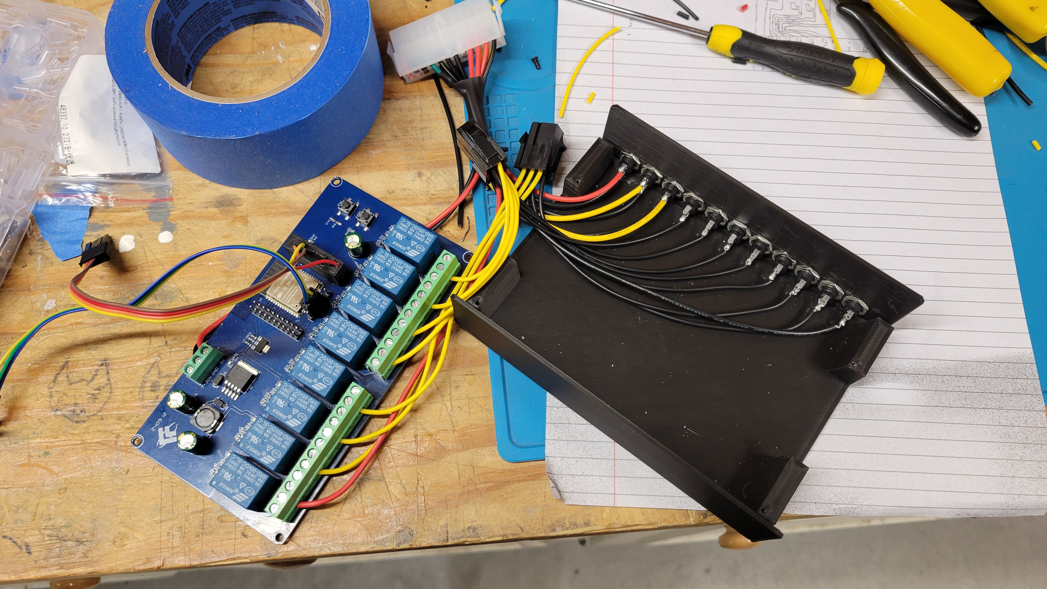
content/docs/buildlog/images/20250119_130754.jpg
