DRuggeri/labinator_site/content/docs/buildlog/images/20250119_133238.jpg

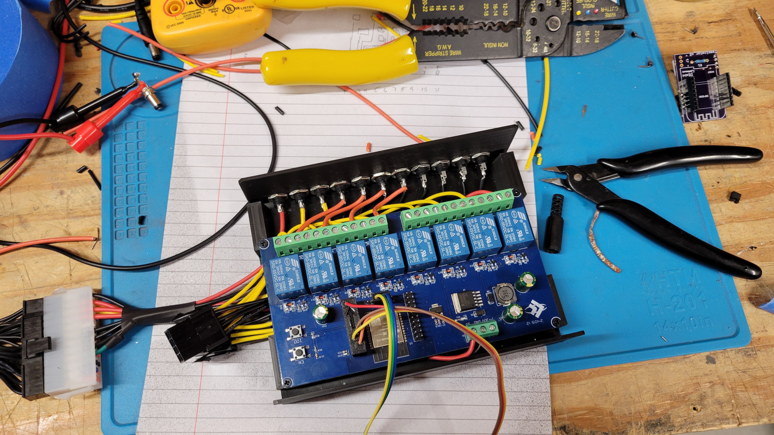
content/docs/buildlog/images/20250119_133238.jpg
