DRuggeri/labinator_site/content/docs/buildlog/images/20250120_113459.jpg

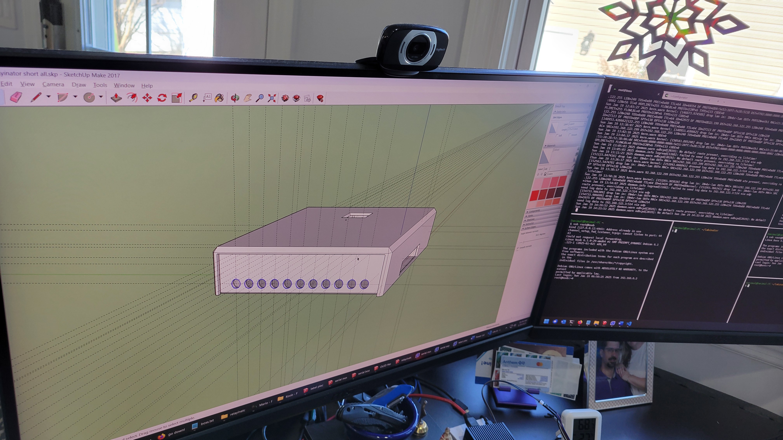
content/docs/buildlog/images/20250120_113459.jpg
