DRuggeri/labinator_site/content/docs/buildlog/images/20250122_062257.jpg

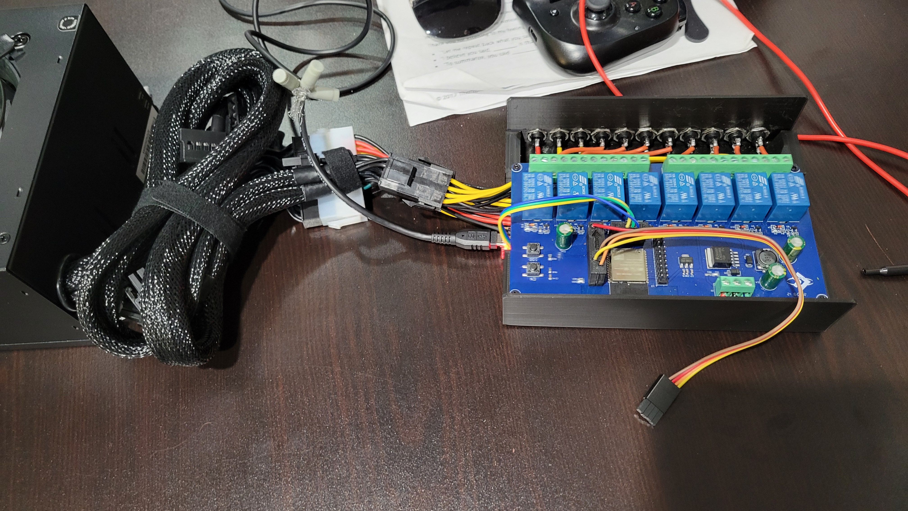
content/docs/buildlog/images/20250122_062257.jpg
