DRuggeri/labinator_site/content/docs/buildlog/images/20250122_070233.jpg

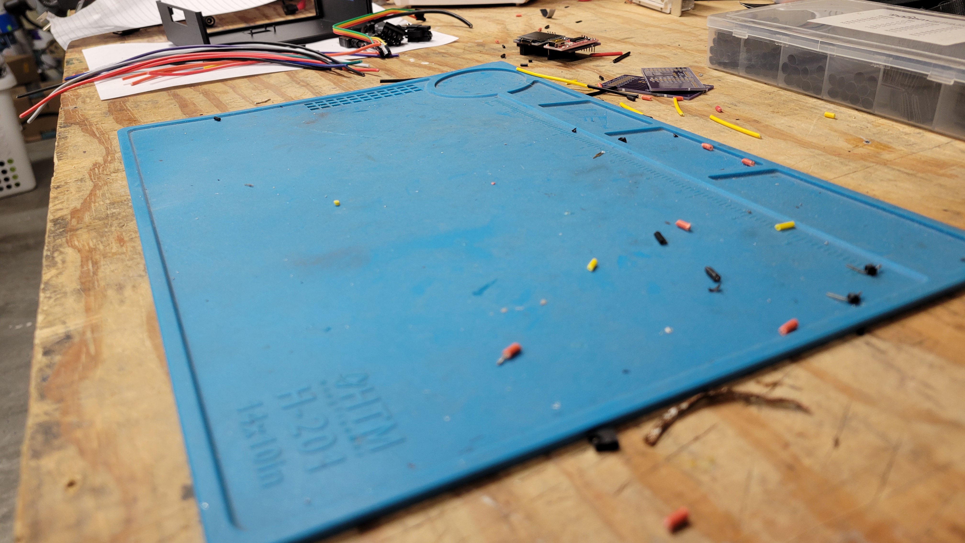
content/docs/buildlog/images/20250122_070233.jpg
