DRuggeri/labinator_site/content/docs/buildlog/images/20250124_163744.jpg

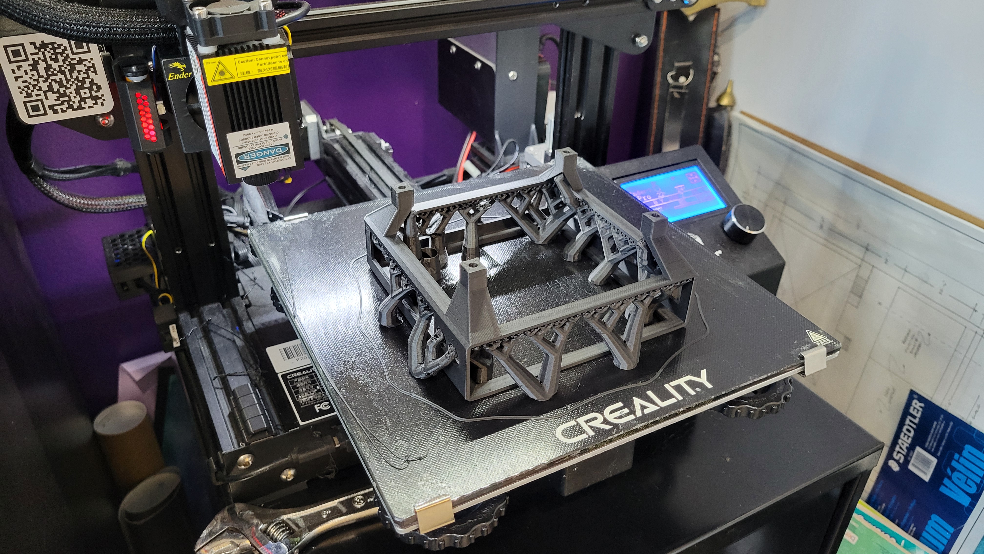
content/docs/buildlog/images/20250124_163744.jpg
