DRuggeri/labinator_site/content/docs/buildlog/images/20250125_100324.jpg

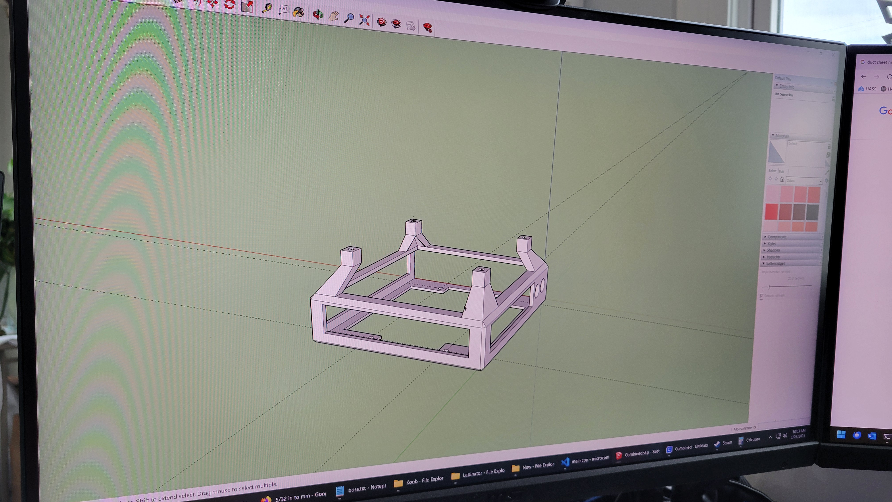
content/docs/buildlog/images/20250125_100324.jpg
