DRuggeri/labinator_site/content/docs/buildlog/images/20250131_200746.jpg

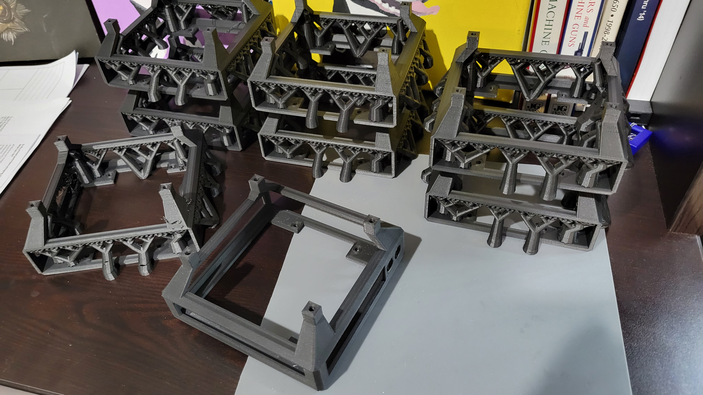
content/docs/buildlog/images/20250131_200746.jpg
