DRuggeri/labinator_site/content/docs/buildlog/images/20250131_204533.jpg

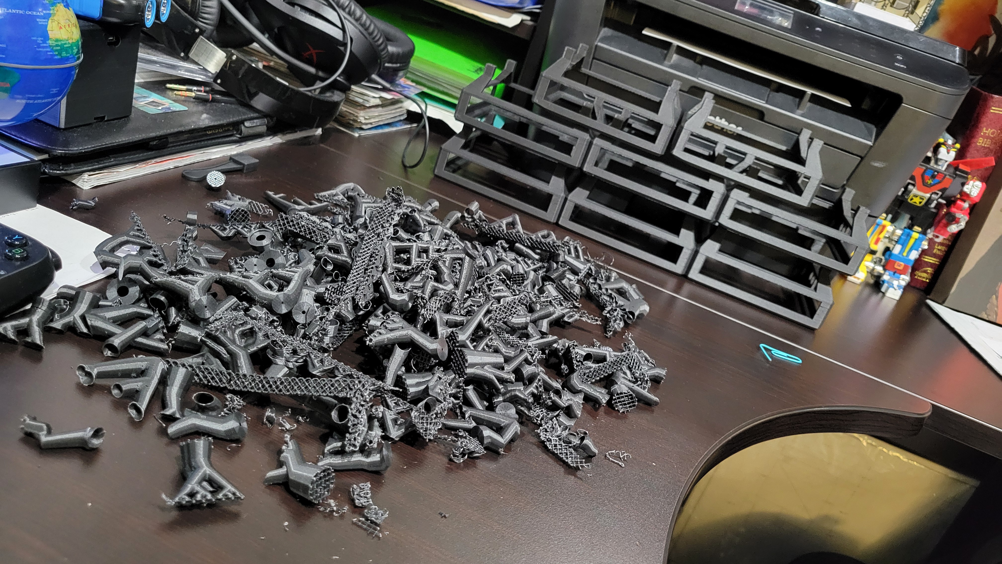
content/docs/buildlog/images/20250131_204533.jpg
