DRuggeri/labinator_site/content/docs/buildlog/images/20250202_141246.jpg

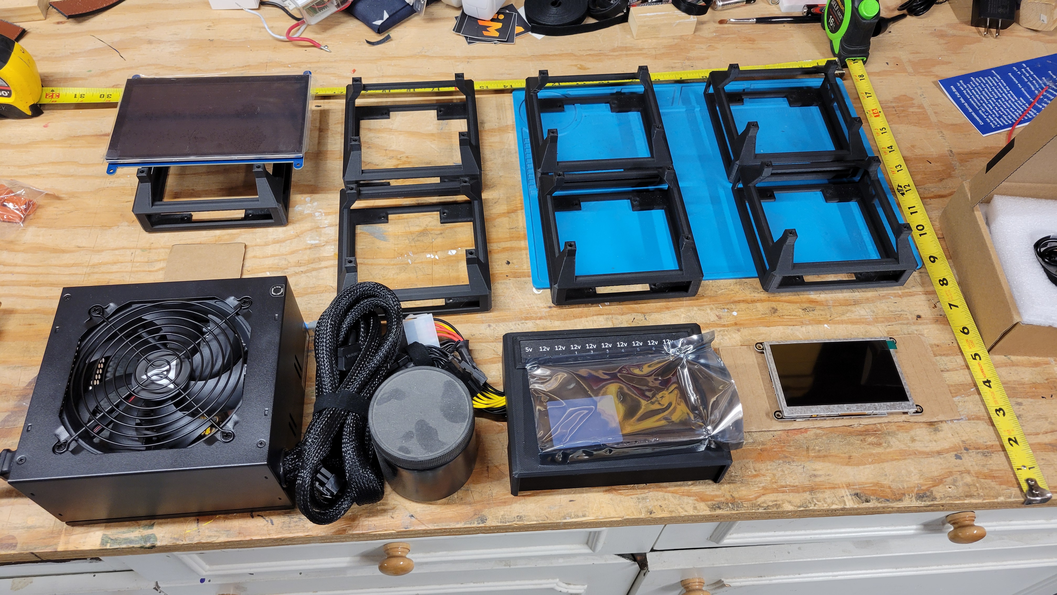
content/docs/buildlog/images/20250202_141246.jpg
