DRuggeri/labinator_site/content/docs/buildlog/images/20250202_141254.jpg

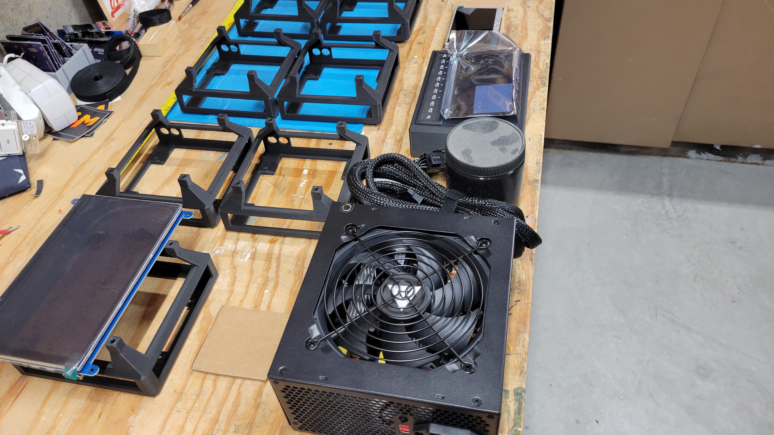
content/docs/buildlog/images/20250202_141254.jpg
