DRuggeri/labinator_site/content/docs/buildlog/images/20250202_163246.jpg

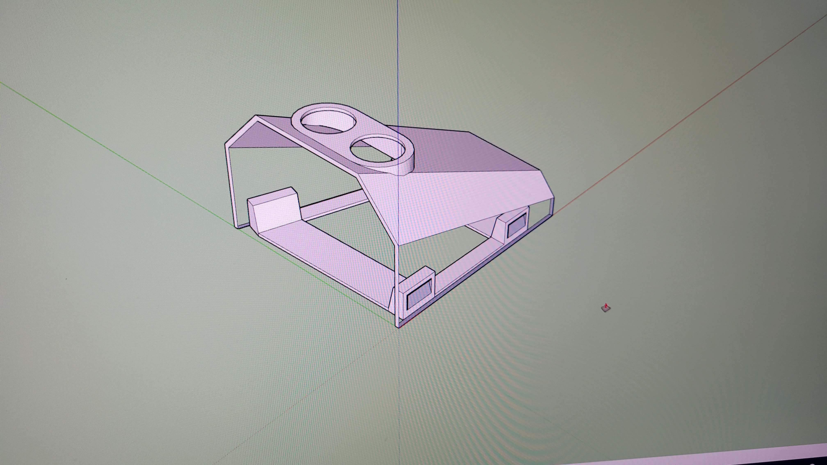
content/docs/buildlog/images/20250202_163246.jpg
