DRuggeri/labinator_site/content/docs/buildlog/images/20250207_074107.jpg

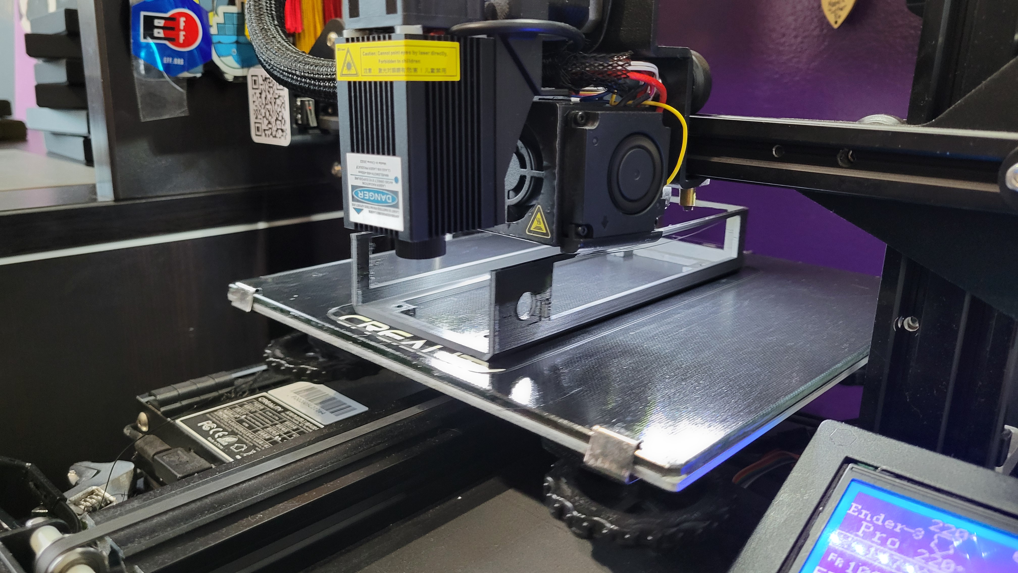
content/docs/buildlog/images/20250207_074107.jpg
