DRuggeri/labinator_site/content/docs/buildlog/images/20250208_093051.jpg

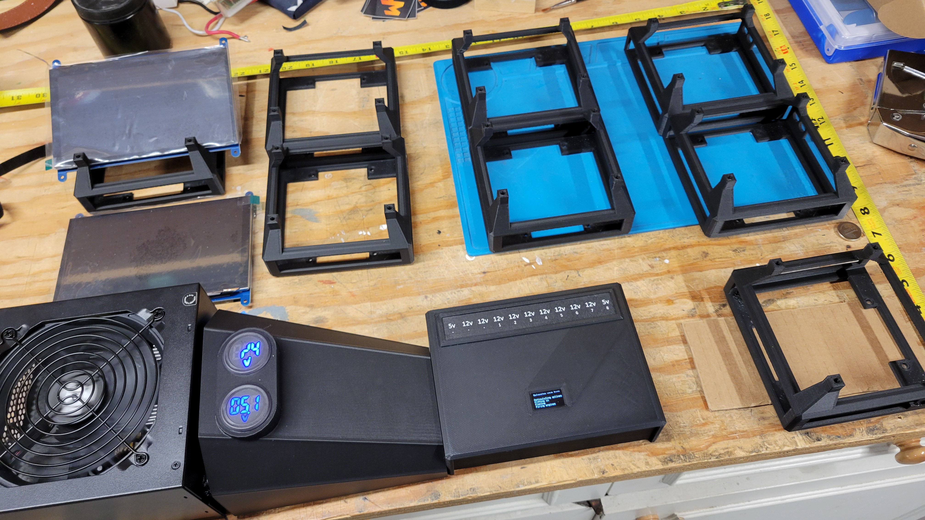
content/docs/buildlog/images/20250208_093051.jpg
