DRuggeri/labinator_site/content/docs/buildlog/images/20250209_154908.jpg

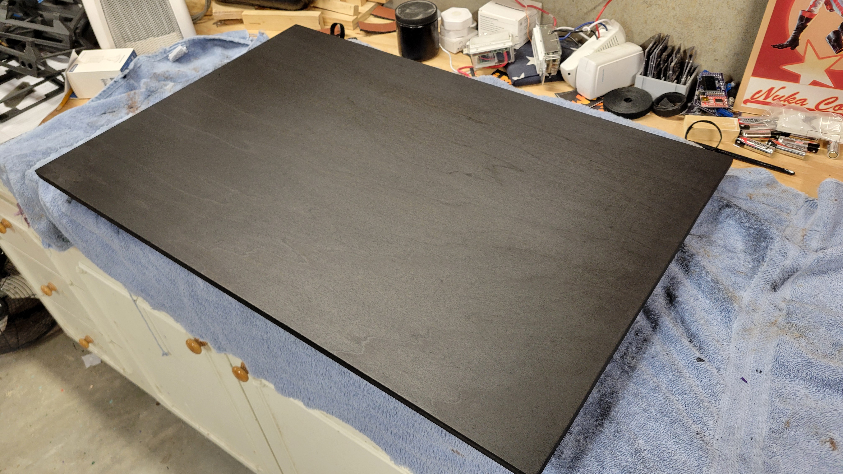
content/docs/buildlog/images/20250209_154908.jpg
