DRuggeri/labinator_site/content/docs/buildlog/images/20250214_052146.jpg

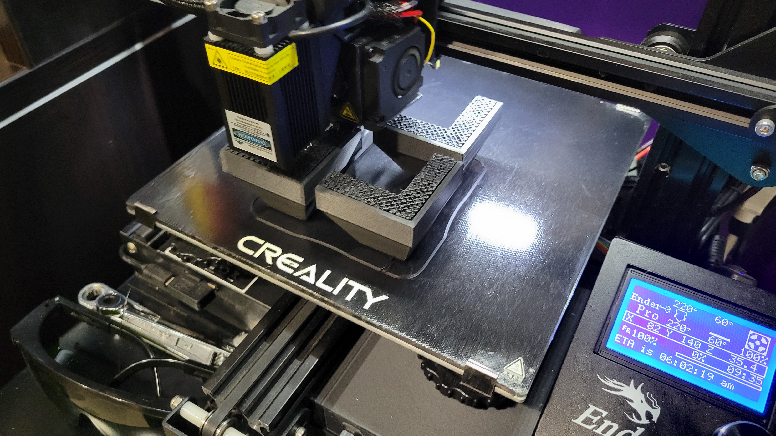
content/docs/buildlog/images/20250214_052146.jpg
