DRuggeri/labinator_site/content/docs/buildlog/images/20250219_061624.jpg

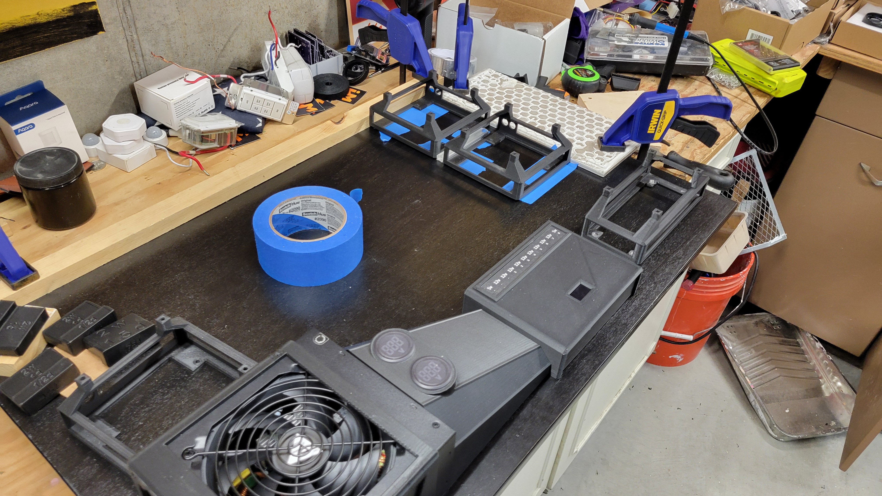
content/docs/buildlog/images/20250219_061624.jpg
