DRuggeri/labinator_site/content/docs/buildlog/images/20250219_064211.jpg

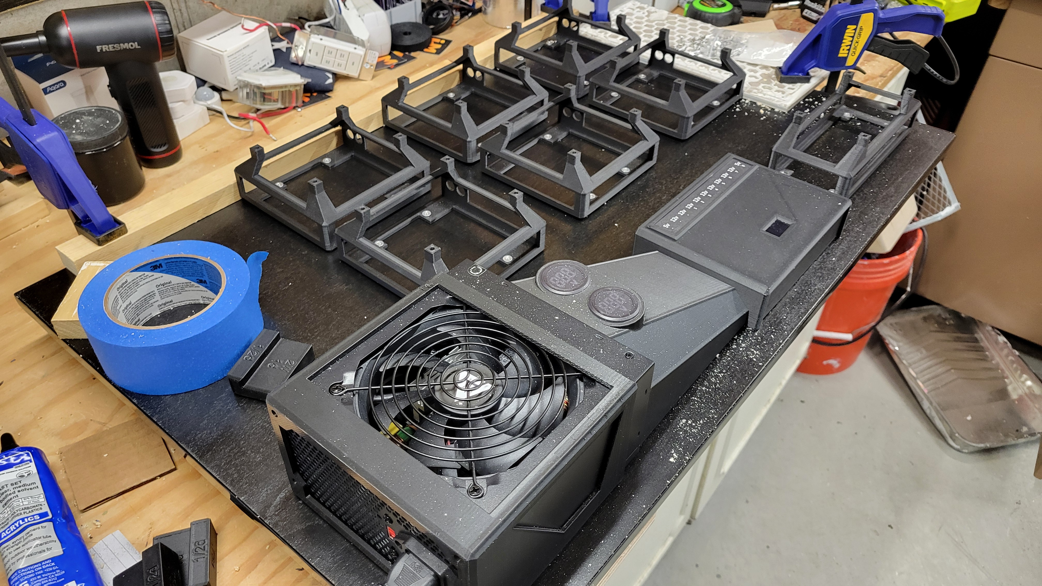
content/docs/buildlog/images/20250219_064211.jpg
