DRuggeri/labinator_site/content/docs/buildlog/images/20250219_064634.jpg

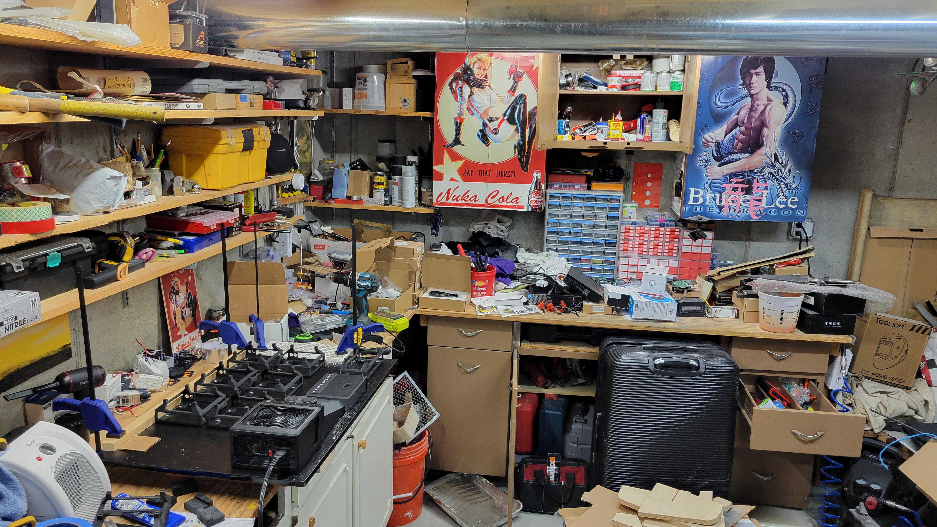
content/docs/buildlog/images/20250219_064634.jpg
