DRuggeri/labinator_site/content/docs/buildlog/images/20250301_093534.jpg

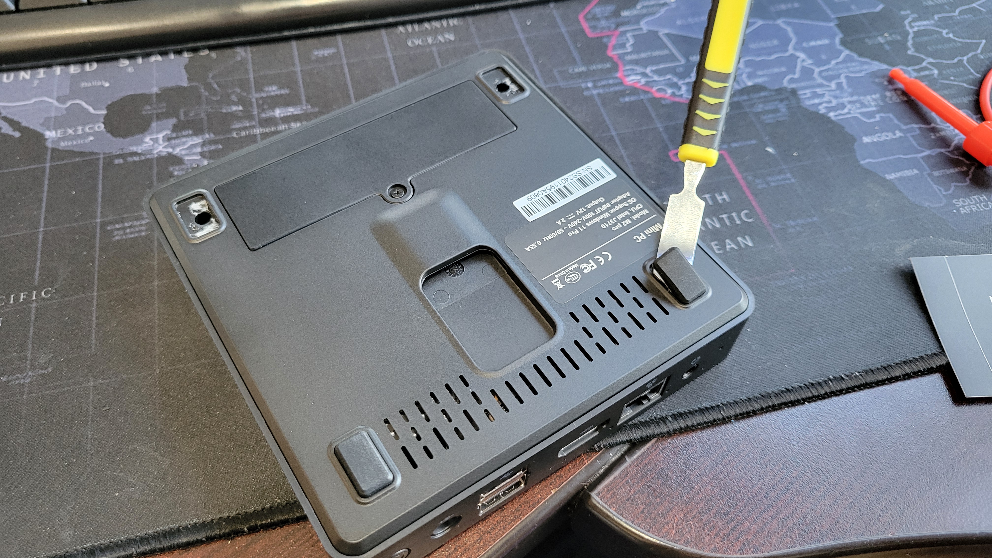
content/docs/buildlog/images/20250301_093534.jpg
