DRuggeri/labinator_site/content/docs/buildlog/images/20250301_093651.jpg

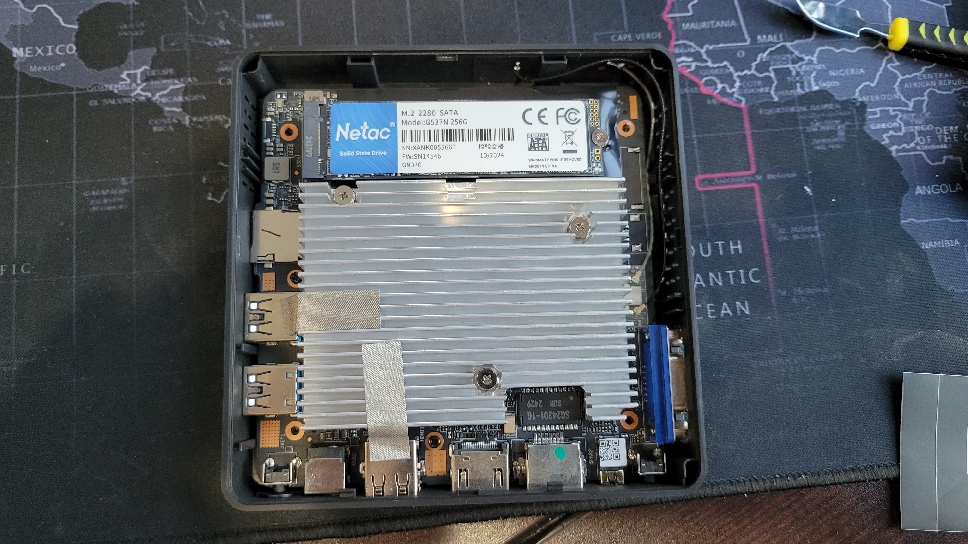
content/docs/buildlog/images/20250301_093651.jpg
