DRuggeri/labinator_site/content/docs/buildlog/images/20250301_093825.jpg

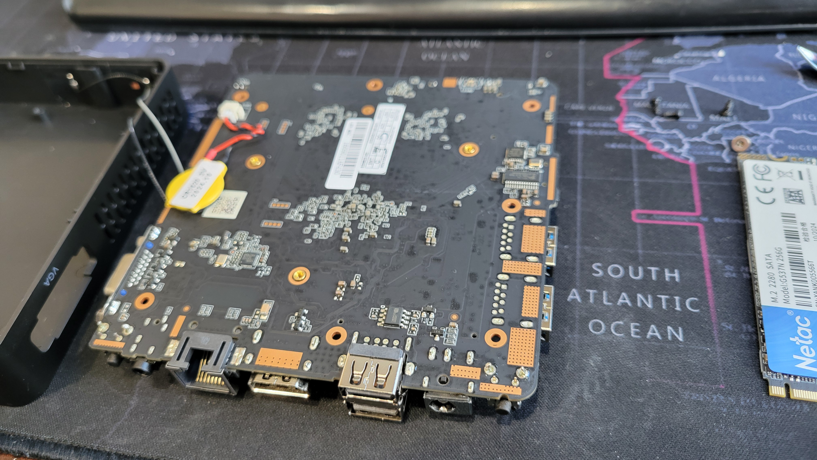
content/docs/buildlog/images/20250301_093825.jpg
