DRuggeri/labinator_site/content/docs/buildlog/images/20250301_094346.jpg

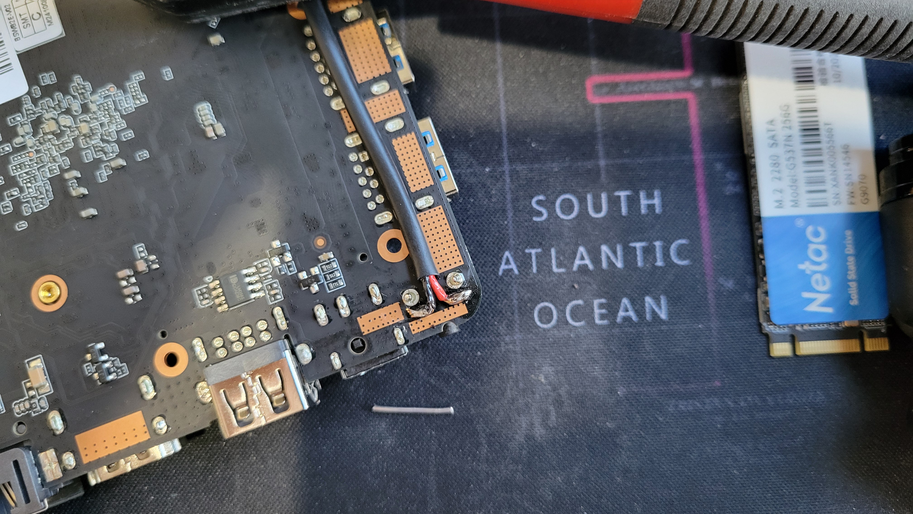
content/docs/buildlog/images/20250301_094346.jpg
