DRuggeri/labinator_site/content/docs/buildlog/images/20250301_105508.jpg

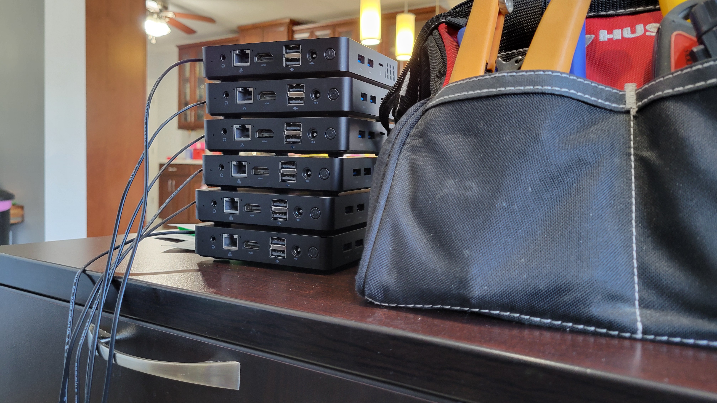
content/docs/buildlog/images/20250301_105508.jpg
