DRuggeri/labinator_site/content/docs/buildlog/images/20250304_202503.jpg

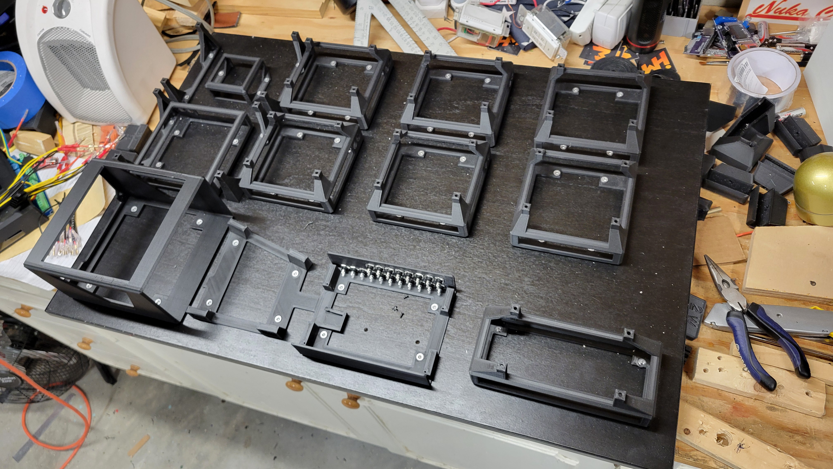
content/docs/buildlog/images/20250304_202503.jpg
