DRuggeri/labinator_site/content/docs/buildlog/images/20250308_195833.jpg

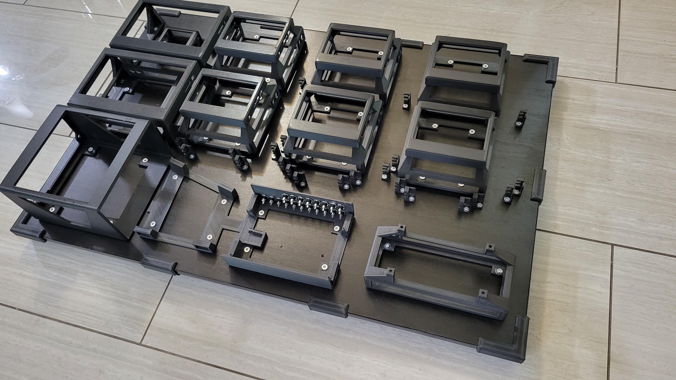
content/docs/buildlog/images/20250308_195833.jpg
