DRuggeri/labinator_site/content/docs/buildlog/images/20250308_195838.jpg

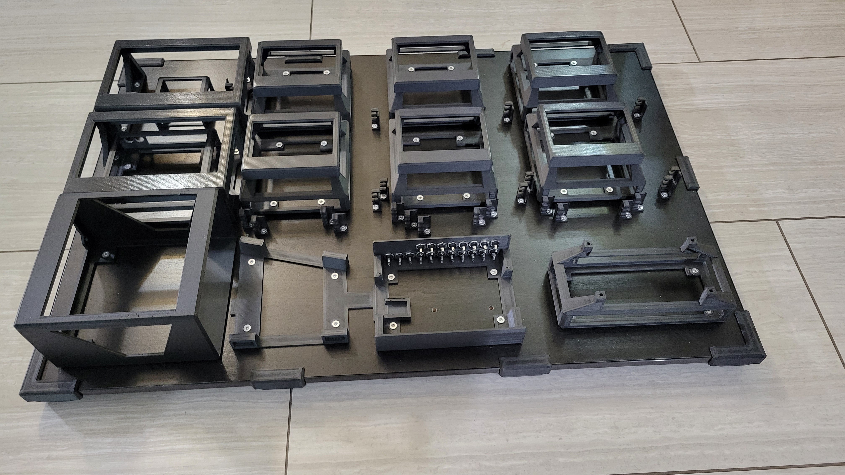
content/docs/buildlog/images/20250308_195838.jpg
