DRuggeri/labinator_site/content/docs/buildlog/images/20250312_202834.jpg

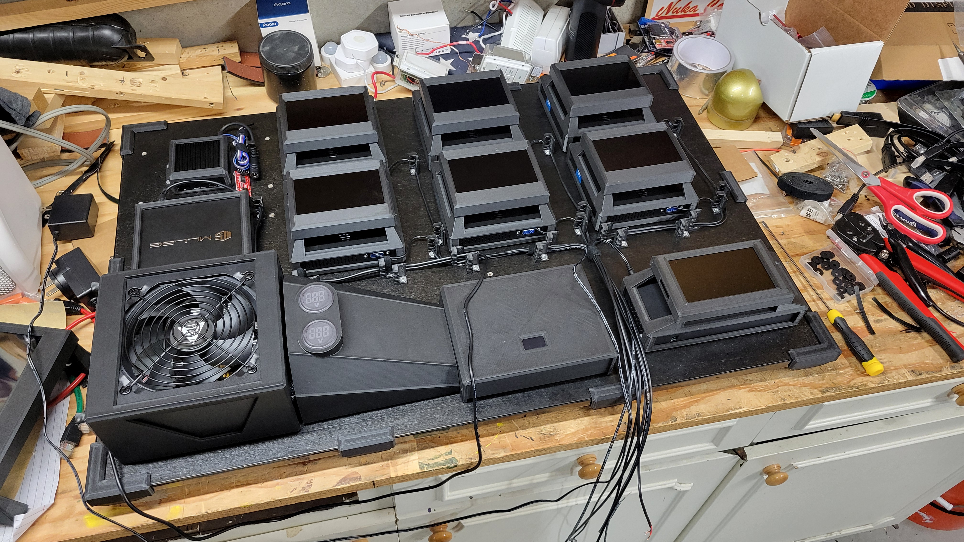
content/docs/buildlog/images/20250312_202834.jpg
