DRuggeri/labinator_site/content/docs/buildlog/images/20250312_202837.jpg

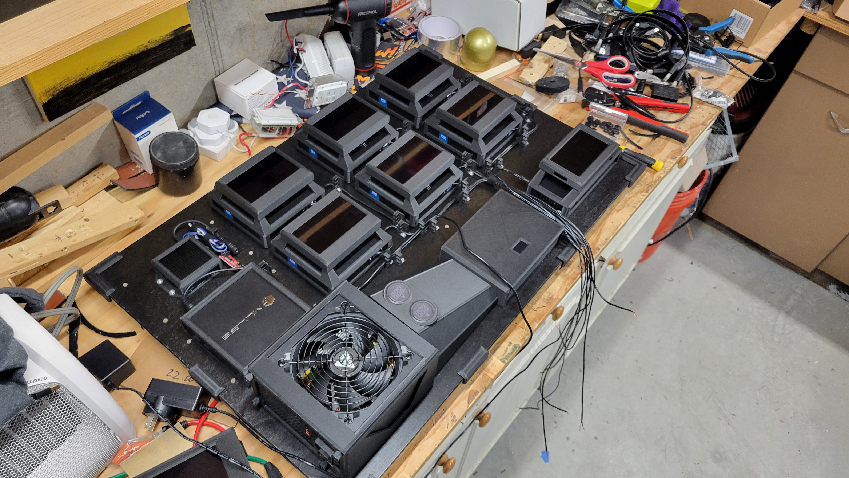
content/docs/buildlog/images/20250312_202837.jpg
