DRuggeri/labinator_site/content/docs/buildlog/images/20250312_203120.jpg

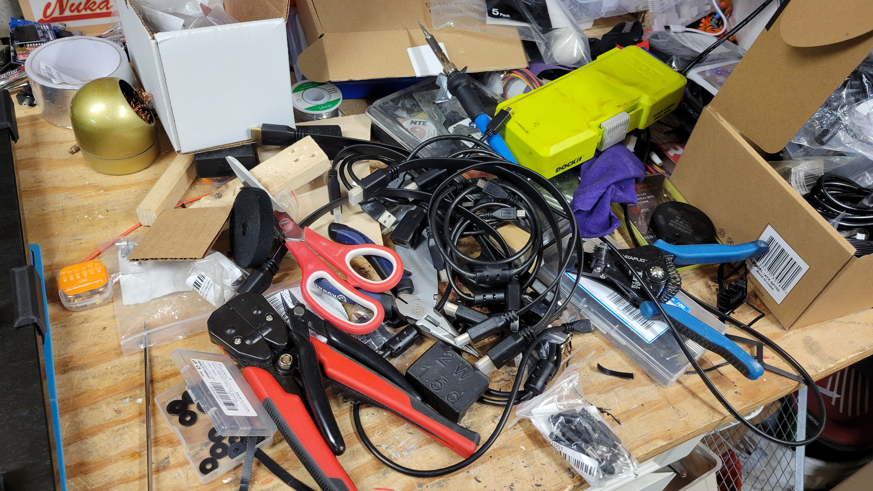
content/docs/buildlog/images/20250312_203120.jpg
