DRuggeri/labinator_site/content/docs/buildlog/images/20250320_072235.jpg

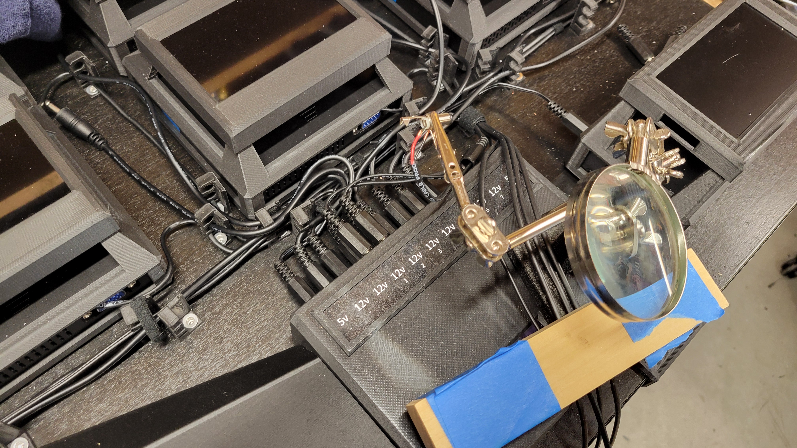
content/docs/buildlog/images/20250320_072235.jpg
