DRuggeri/labinator_site/content/docs/buildlog/images/20250322_181817.jpg

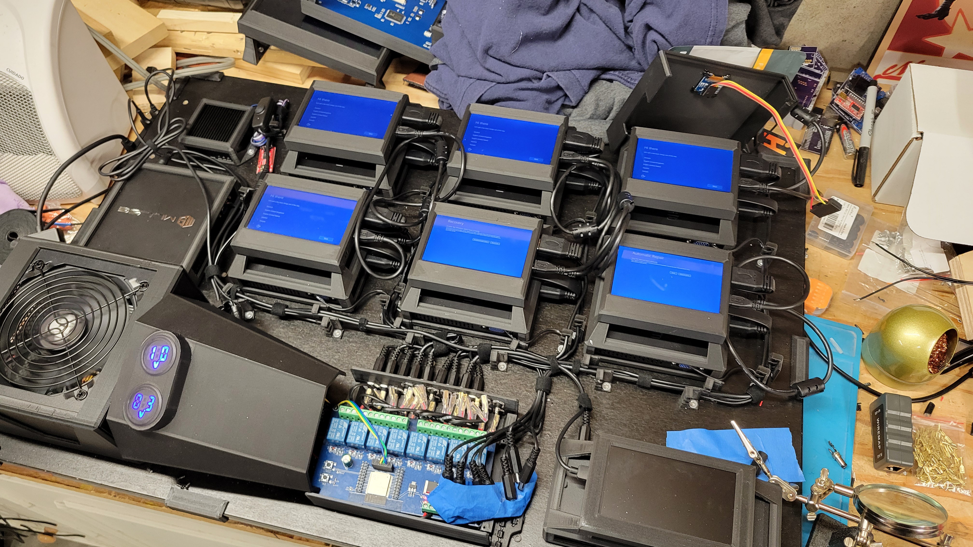
content/docs/buildlog/images/20250322_181817.jpg
