DRuggeri/labinator_site/content/docs/buildlog/images/20250323_155624.jpg

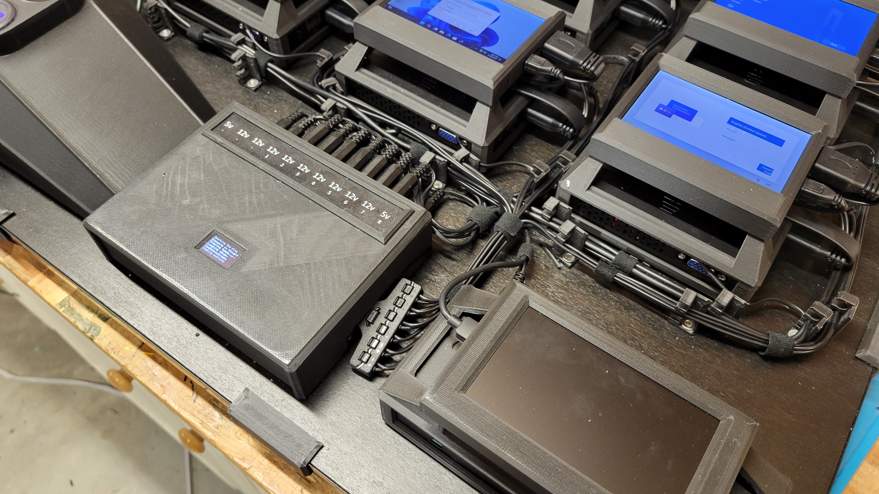
content/docs/buildlog/images/20250323_155624.jpg
