DRuggeri/labinator_site/content/docs/buildlog/images/20250323_161005.jpg

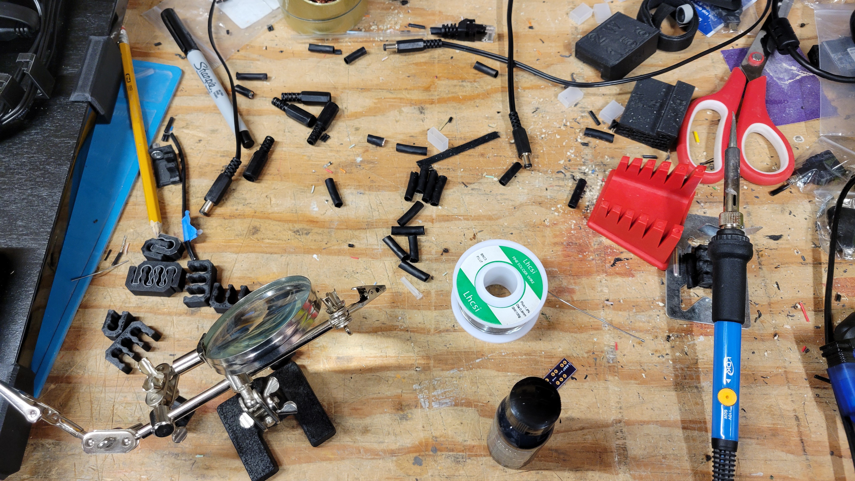
content/docs/buildlog/images/20250323_161005.jpg
