DRuggeri/labinator_site/content/docs/buildlog/images/20250323_163531.jpg

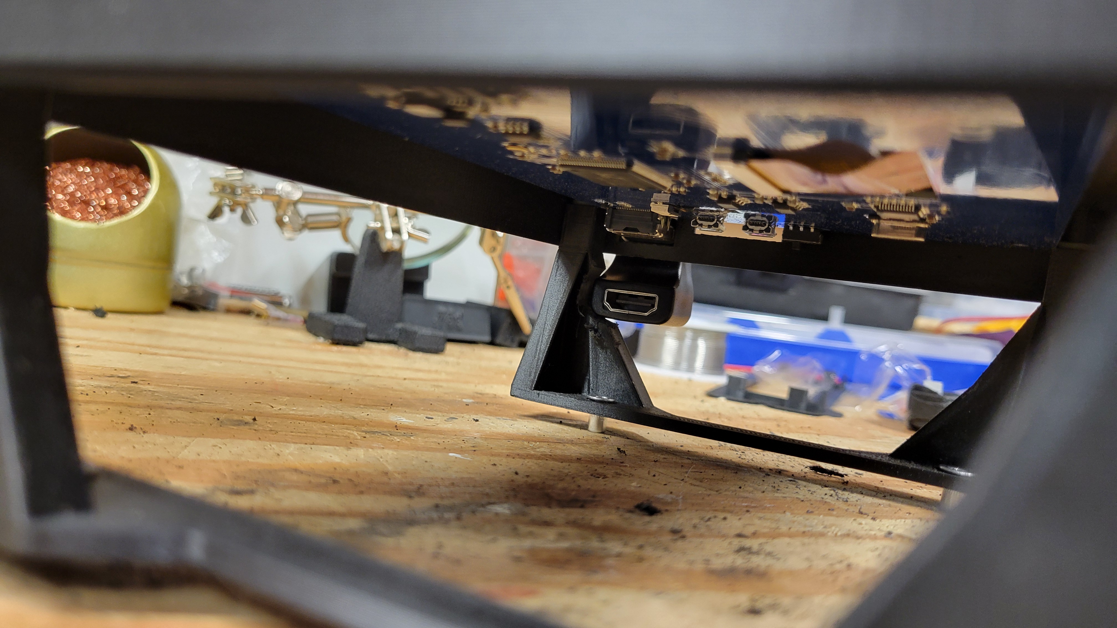
content/docs/buildlog/images/20250323_163531.jpg
