DRuggeri/labinator_site/content/docs/buildlog/images/20250326_202955.jpg

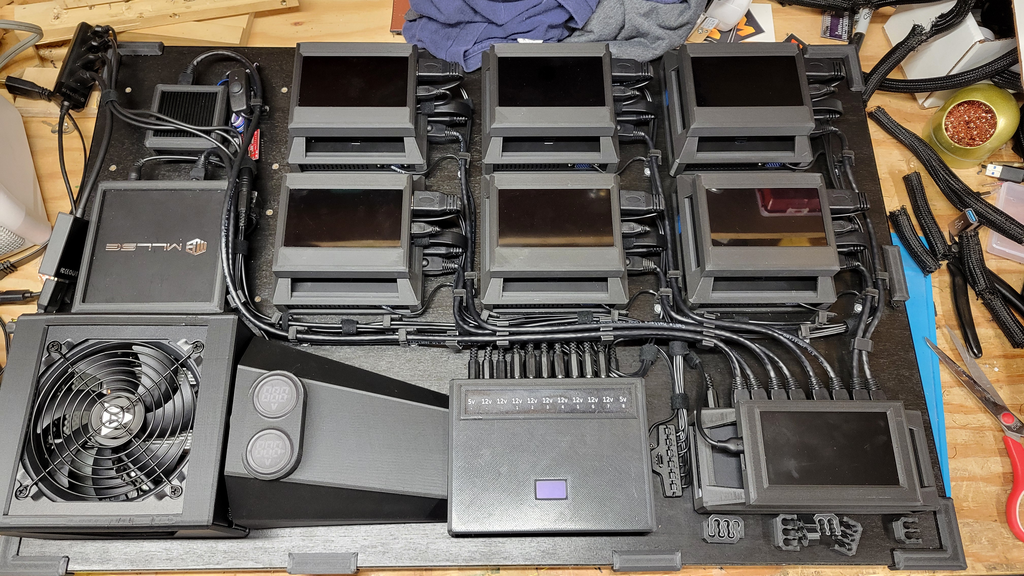
content/docs/buildlog/images/20250326_202955.jpg
