DRuggeri/labinator_site/content/docs/buildlog/images/20250326_203018.jpg

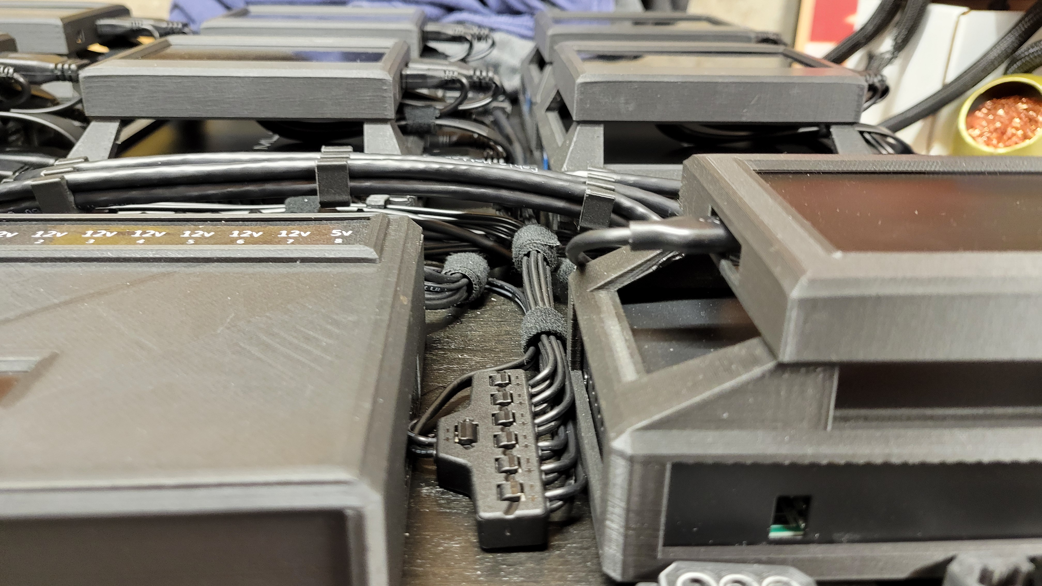
content/docs/buildlog/images/20250326_203018.jpg
