DRuggeri/labinator_site/content/docs/buildlog/images/20250603_184744.jpg

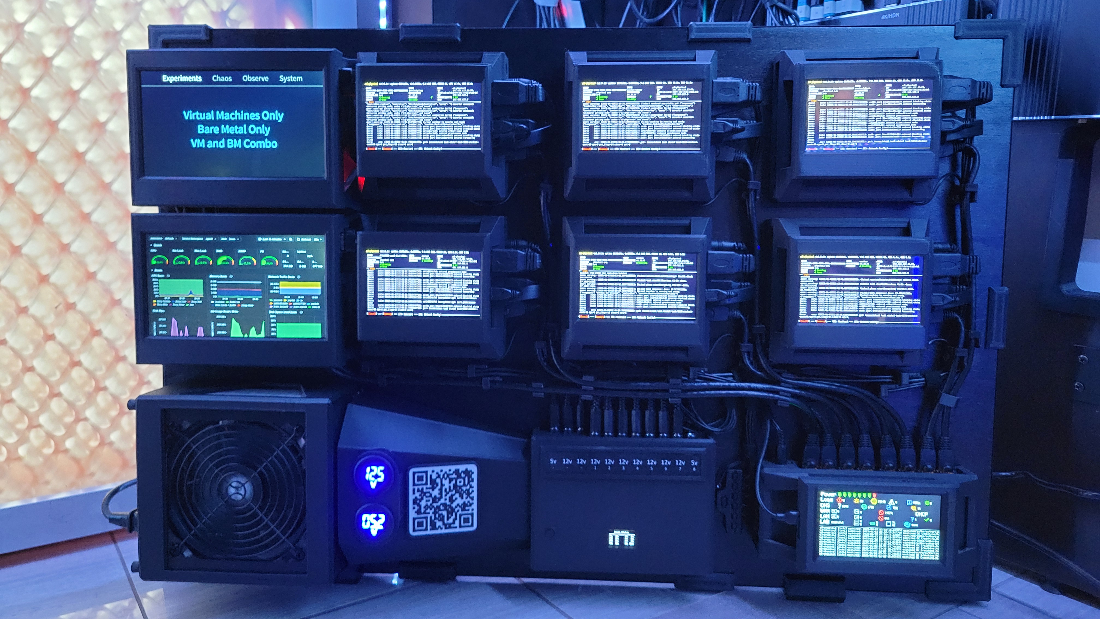
content/docs/buildlog/images/20250603_184744.jpg
