DRuggeri/labinator_site/content/docs/buildlog/images/20250603_185110.jpg

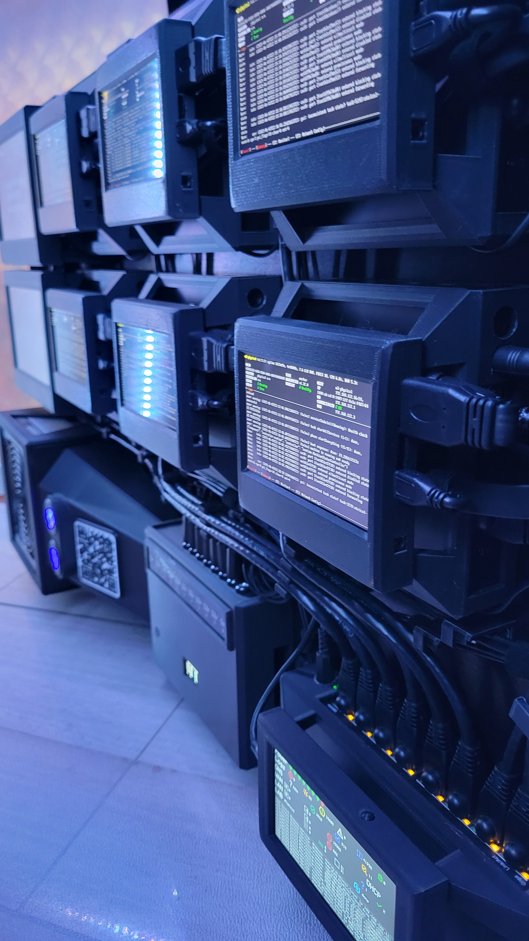
content/docs/buildlog/images/20250603_185110.jpg
