DRuggeri/labinator_site/content/docs/buildlog/images/20250603_185216.jpg

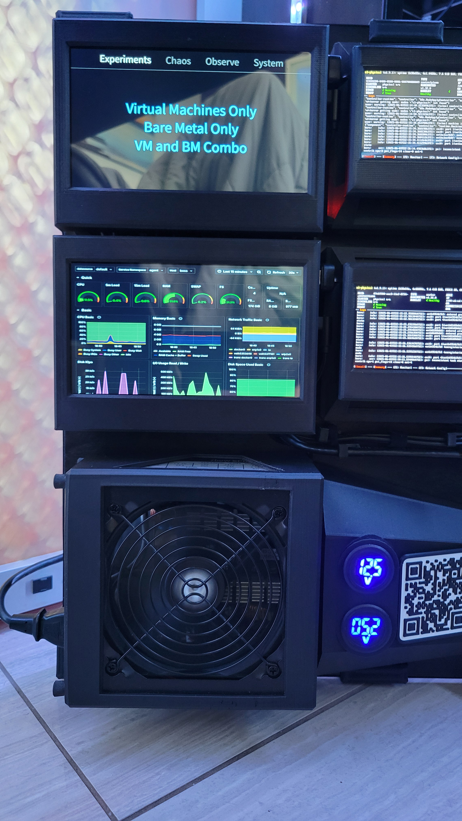
content/docs/buildlog/images/20250603_185216.jpg
