DRuggeri/labinator_site/content/docs/buildlog/images/20250603_190020.jpg

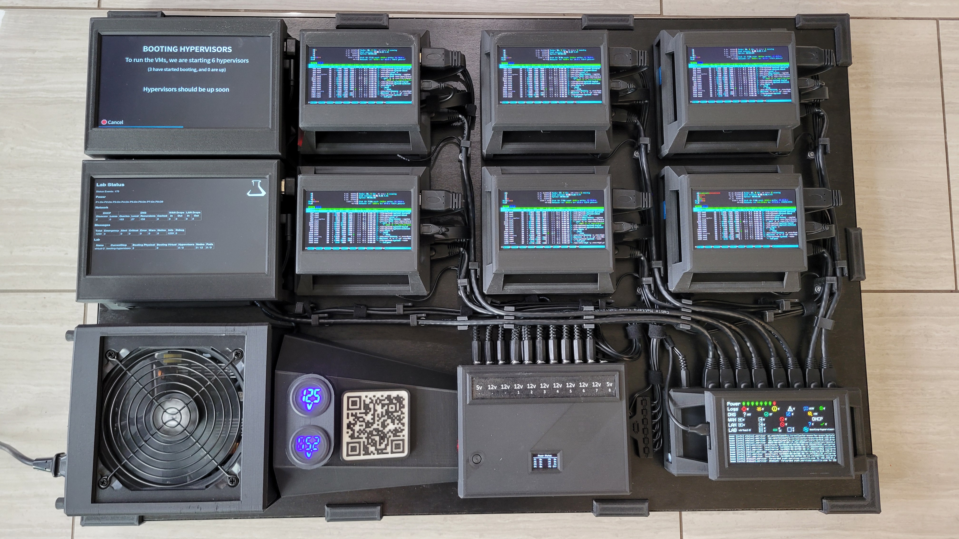
content/docs/buildlog/images/20250603_190020.jpg
