DRuggeri/labinator_site/content/docs/buildlog/images/20250603_190133.jpg

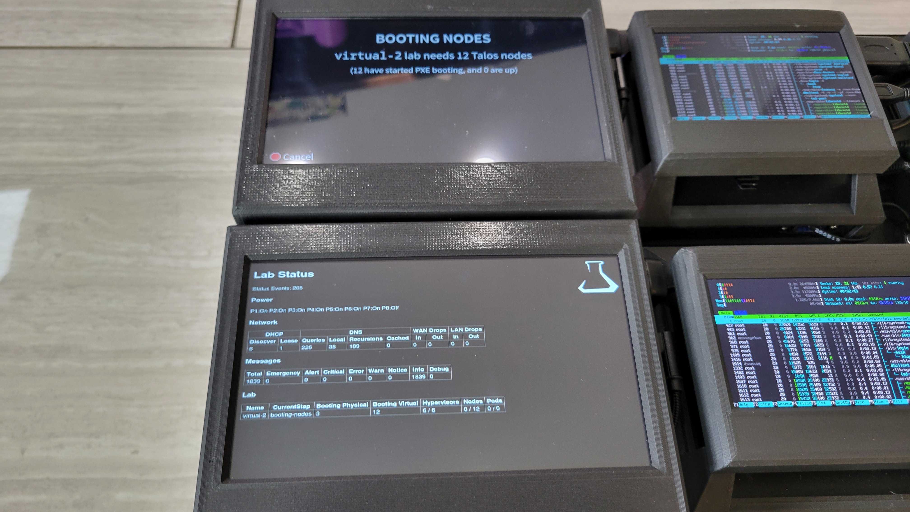
content/docs/buildlog/images/20250603_190133.jpg
