DRuggeri/labinator_site/content/docs/buildlog/images/20250603_190840.jpg

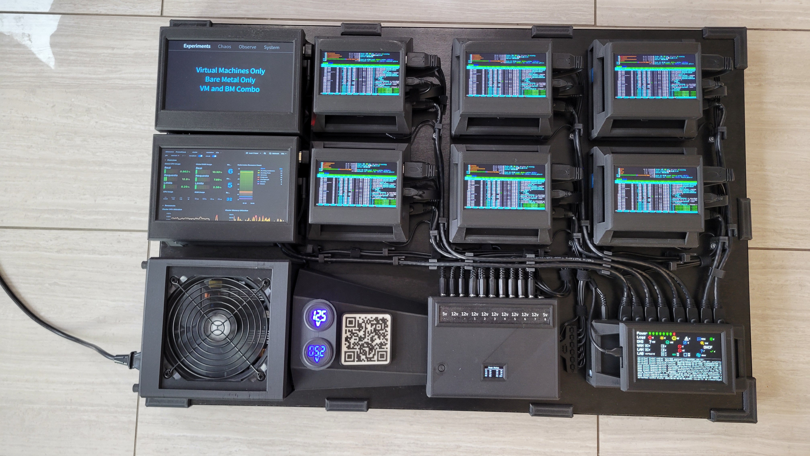
content/docs/buildlog/images/20250603_190840.jpg
