DRuggeri/labinator_site/content/docs/buildlog/images/20250603_191447.jpg

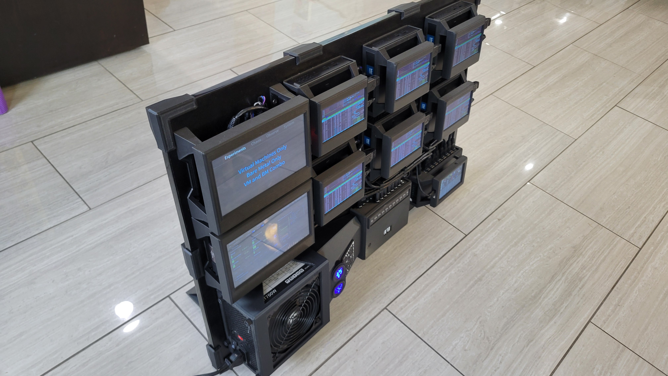
content/docs/buildlog/images/20250603_191447.jpg
