DRuggeri/labinator_site/content/docs/buildlog/images/20250603_191646.jpg

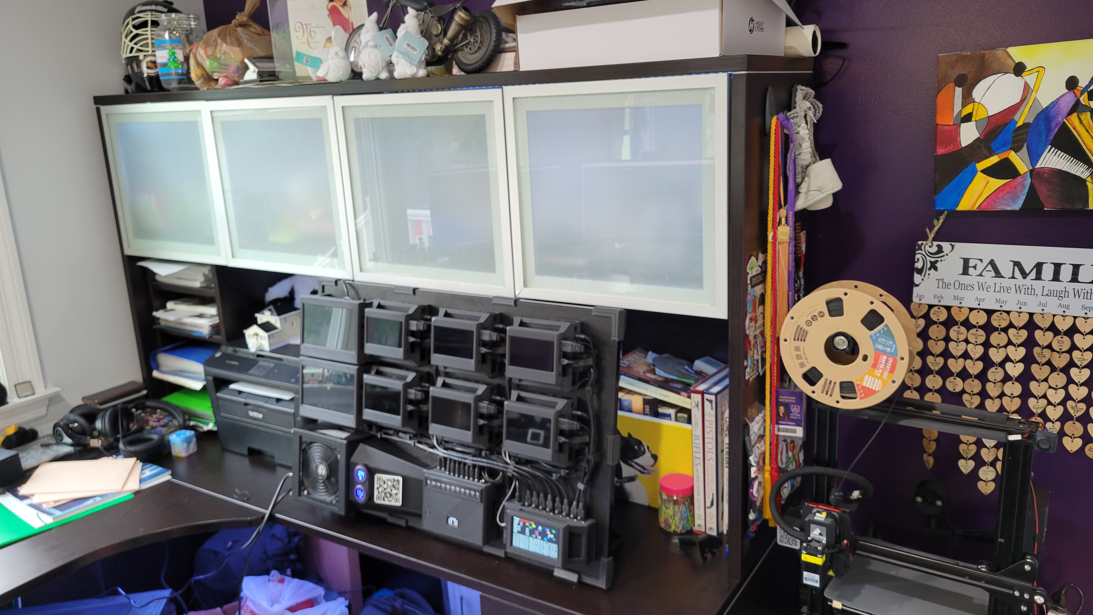
content/docs/buildlog/images/20250603_191646.jpg
