DRuggeri/labinator_site/(commit log)

2025-02-15 Add in 3D models
    [ATX Mount.skp, ATX Mount.stl, Combined.skp, Combined.stl, Computer Holster.skp, Computer Holster.stl, ESPLCD Button.skp, ESPLCD Button.stl]
2025-02-15 Improve style of modelviewer
    [ATX Mount.skp, ATX Mount.stl]
2025-02-15 Power wire cover split to two models
    [Power Wire Cover - bottom.skp, Power Wire Cover - top.skp, Power Wire Cover.skp, Power Wire Cover.stl]
2025-02-15 Progress bar fixes for models page
    [Screen Button.stl]
2025-02-16 Update ATX mount
    [ATX Mount.skp, ATX Mount.stl]
2025-02-16 Raise camera a bit?
2025-02-16 Increase height
    [Platform corner leg.skp, Platform corner leg.stl, Platform edge leg.skp, Platform edge leg.stl]
2025-02-19 Update names
    [Holster with Screen.skp, Holster with Screen.stl, Holster.skp, Holster.stl]
2025-03-07 Move from Jekyll to Hugo
    [ATX Mount.skp, ATX Mount.stl, Cable Comb.skp, Cable Comb.stl, ESPLCD Button.skp, ESPLCD Button.stl, ESPLCD Screen.skp, ESPLCD Screen.stl]
2025-03-09 Add landing page
2025-03-09 Add BOM page
2025-03-16 Finalize the models pages
    [Relayinator Bottom.skp, Relayinator Bottom.stl, Relayinator Top.skp, Relayinator Top.stl]
2025-03-27 More docs and images
    [USB Holster.skp, USB Holster.stl]
2025-03-30 Add the minimal LCD touch mount
    [LCD - Touch Mount - Minimal.skp, LCD - Touch Mount - Minimal.stl]
2025-04-13 Toss qrcode holder in the mix
    [QRCode Holder.skp, QRCode Holder.stl, qrcode.stl]
2025-06-04 Add some more assets and a new logo
    [Platform Stand.skp, Platform Stand.stl]
2025-06-04 Add new landing image
2025-09-14 Ensmallen the landing image
2025-09-14 Set up keyboard navigation in the gallery lightbox
    [Power Wire Cover - bottom.skp, Power Wire Cover - bottom.stl, Power Wire Cover - top.skp, Power Wire Cover - top.stl]
2025-09-21 Fix switch port numbers
2025-09-26 Add carrying handle and lug
    [Carry Handle.skp, Carry Handle.stl, Mounting Lug.skp, Mounting Lug.stl, qrcode.stl]
2025-09-30 Flesh out wireless config (WIP) and USB port attachments
